arcticlula/Netscore/README.md

# Netscore
Device that keeps track of a volleyball's game score (points and sets). 

Ideally it should be mounted on the net, since it has a display on the front and back and buttons on the sides.
