arcticlula/Netscore/docs/0.8in.webp

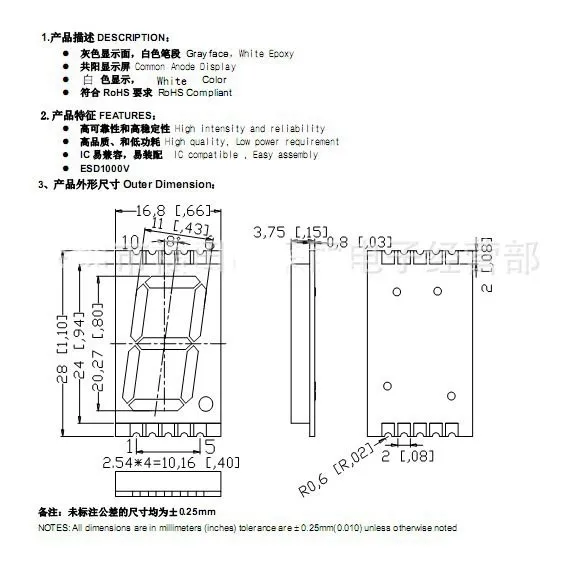
docs/0.8in.webp
