arcticlula/Netscore/docs/3P-Dial-Wheel-Switch-4-1100x1100w.jpg

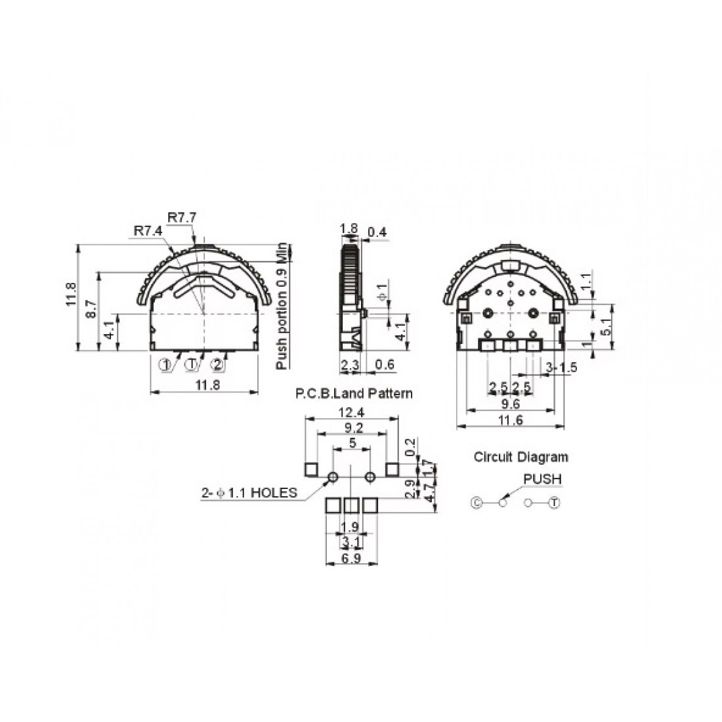
docs/3P-Dial-Wheel-Switch-4-1100x1100w.jpg
