arcticlula/Netscore/docs/esp32 s2 wroom pinout.png

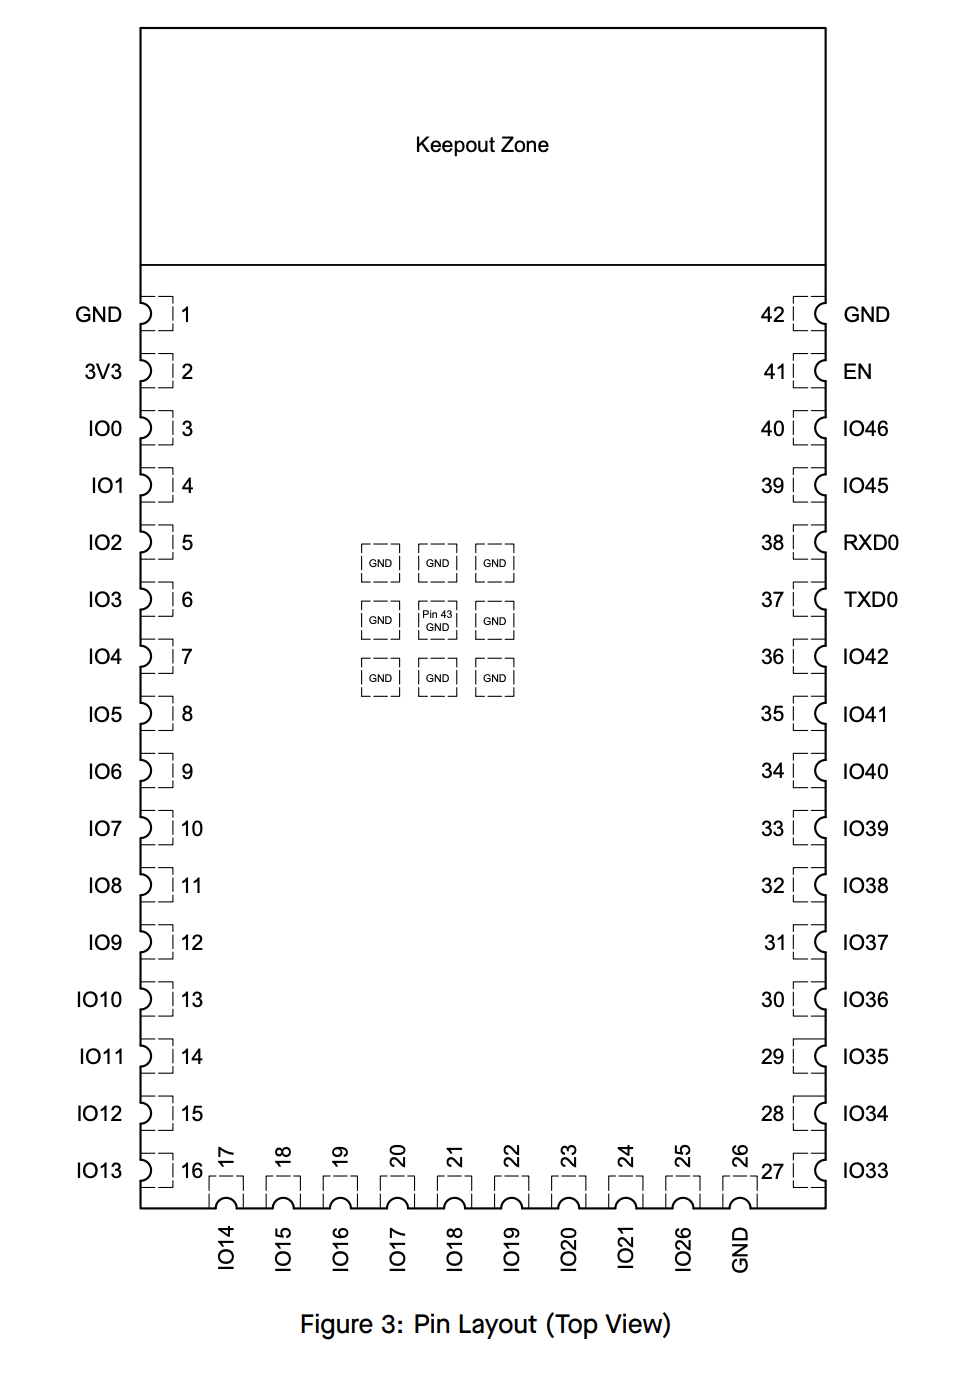
docs/esp32 s2 wroom pinout.png
