arcticlula/Netscore/docs/esp32 s3 wroom pinout.png

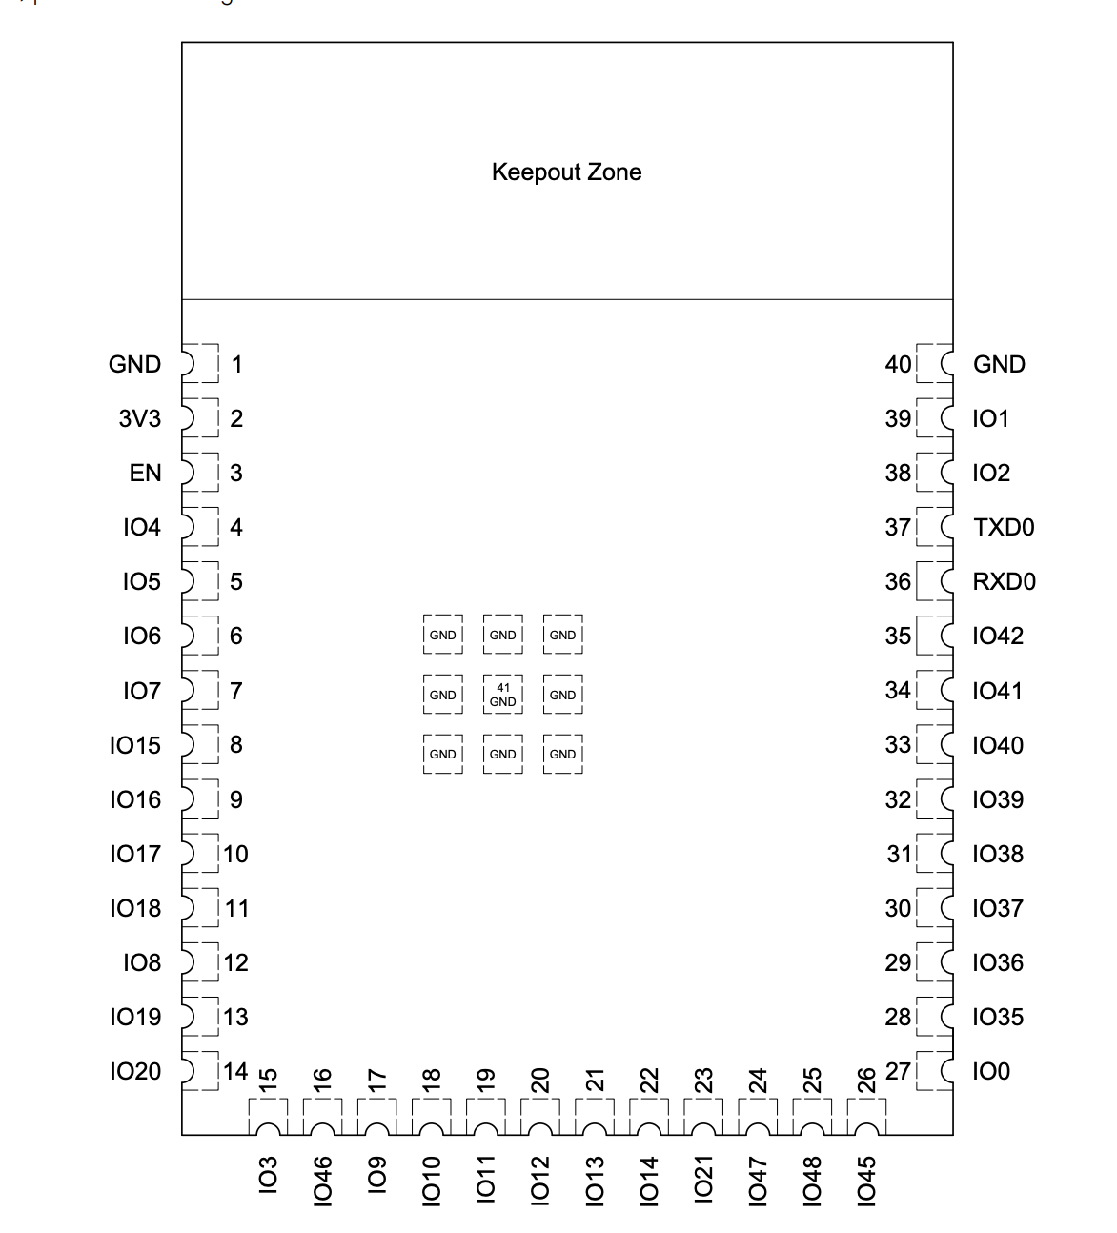
docs/esp32 s3 wroom pinout.png
