arcticlula/Netscore/docs/fish.png

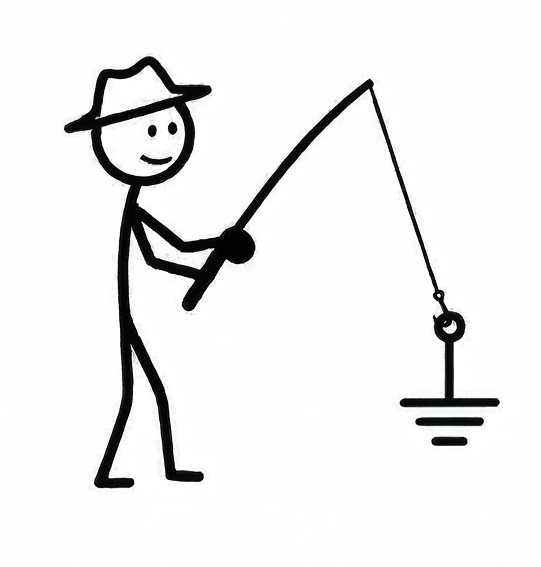
docs/fish.png
