arcticlula/Netscore/docs/rake.png

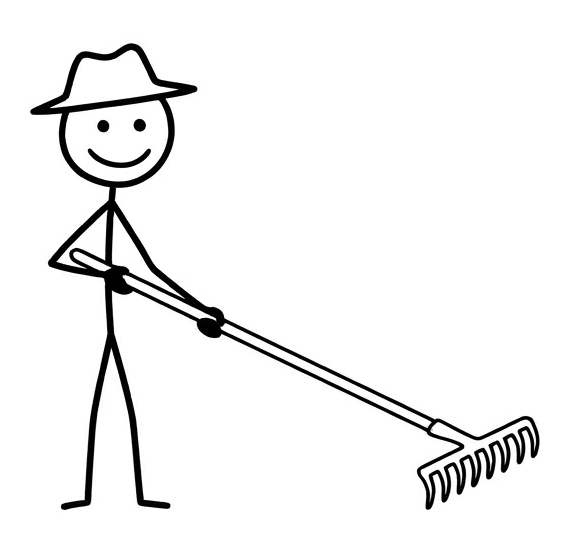
docs/rake.png
