arcticlula/Netscore/docs/S2cf5b9a6ac8e40838b927087fc219b81M.webp

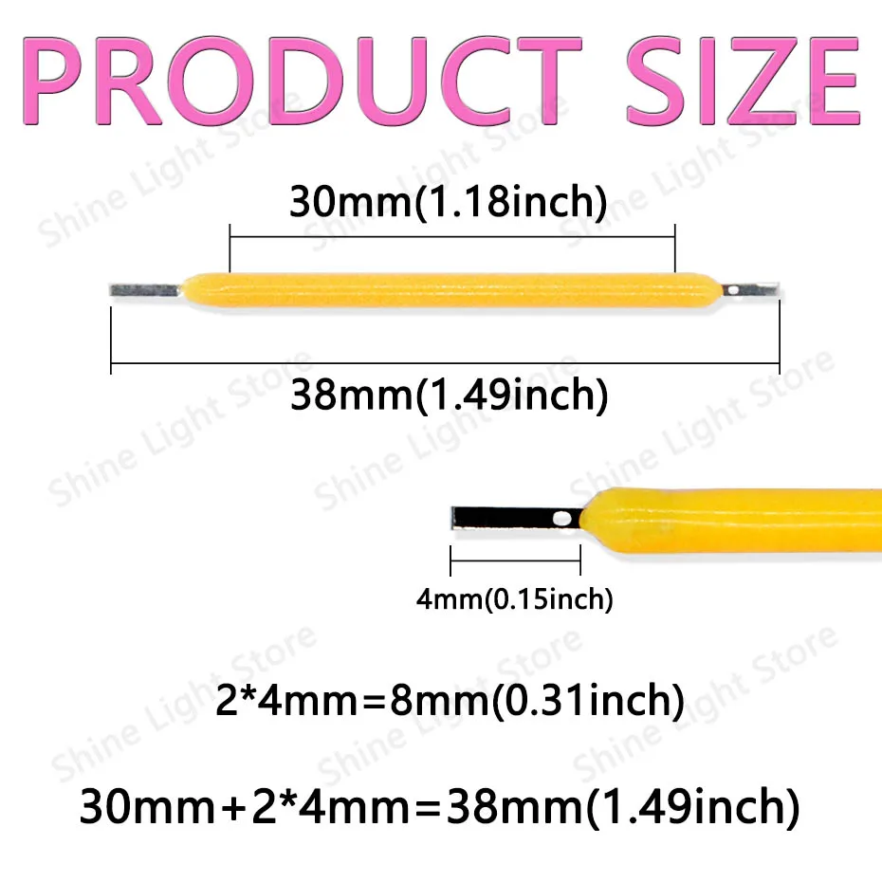
docs/S2cf5b9a6ac8e40838b927087fc219b81M.webp
