arcticlula/Netscore/docs/S14ab36efa070481e8fa8c75f21a35941z.webp

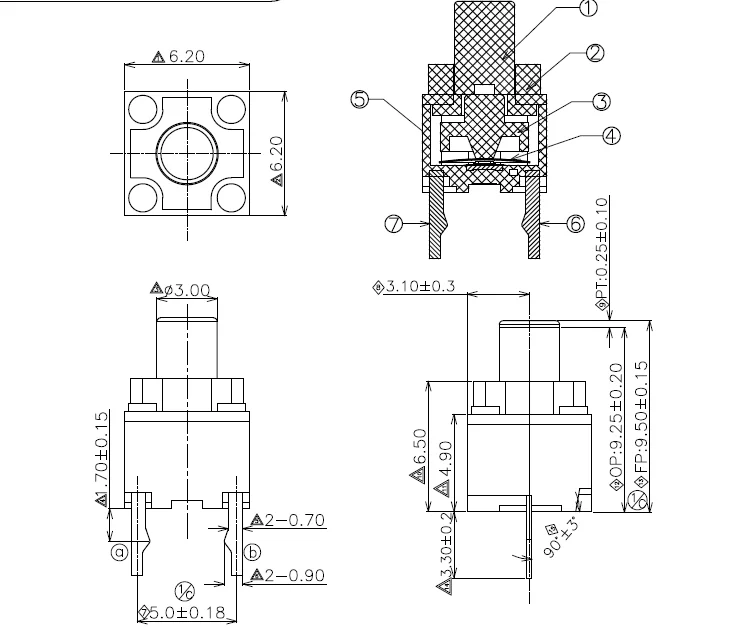
docs/S14ab36efa070481e8fa8c75f21a35941z.webp
