arcticlula/Netscore/docs/S18a682a4f3614c669764446a9c4d551fz.webp

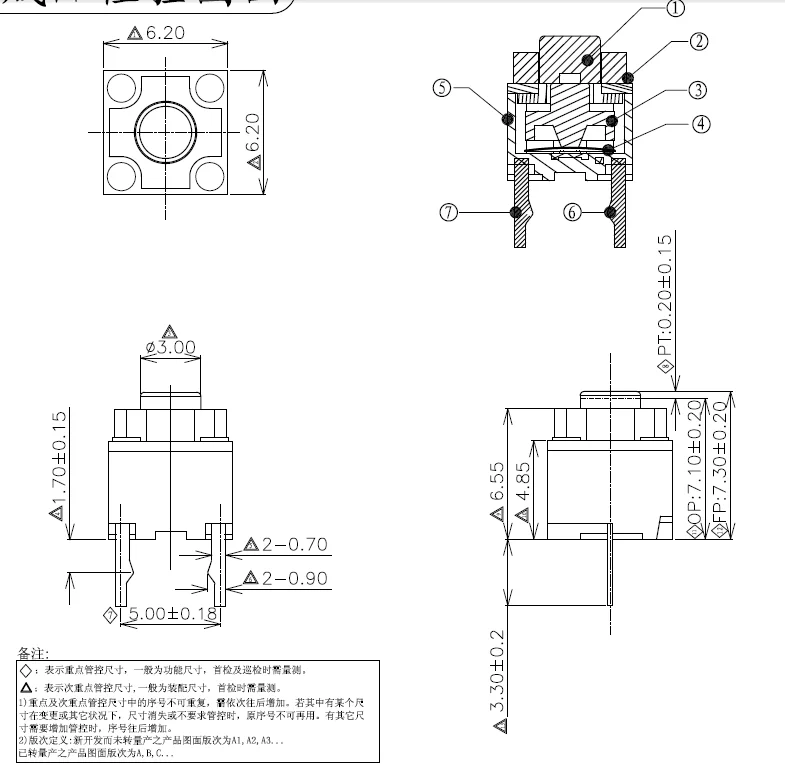
docs/S18a682a4f3614c669764446a9c4d551fz.webp
