arcticlula/Netscore/docs/S4806a1bc822145efa5b5a5cded0fcb83w.webp

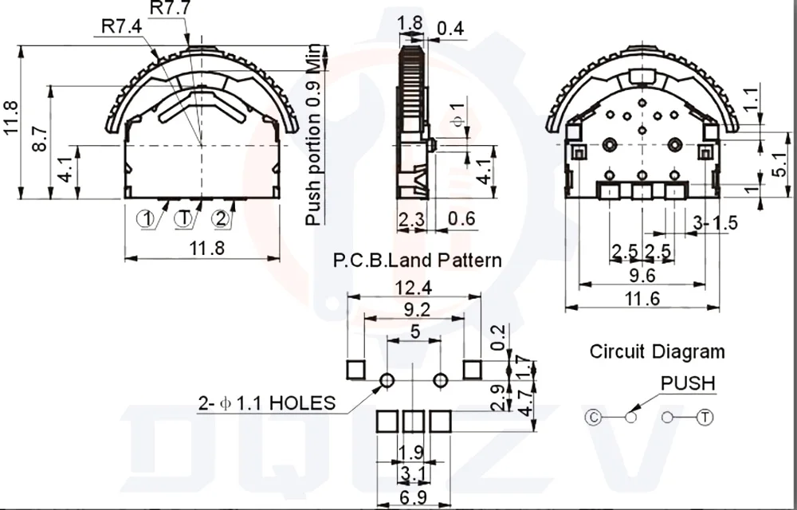
docs/S4806a1bc822145efa5b5a5cded0fcb83w.webp
