arcticlula/Netscore/docs/Sd6c0362663b042cd87066699b7182b00w.webp

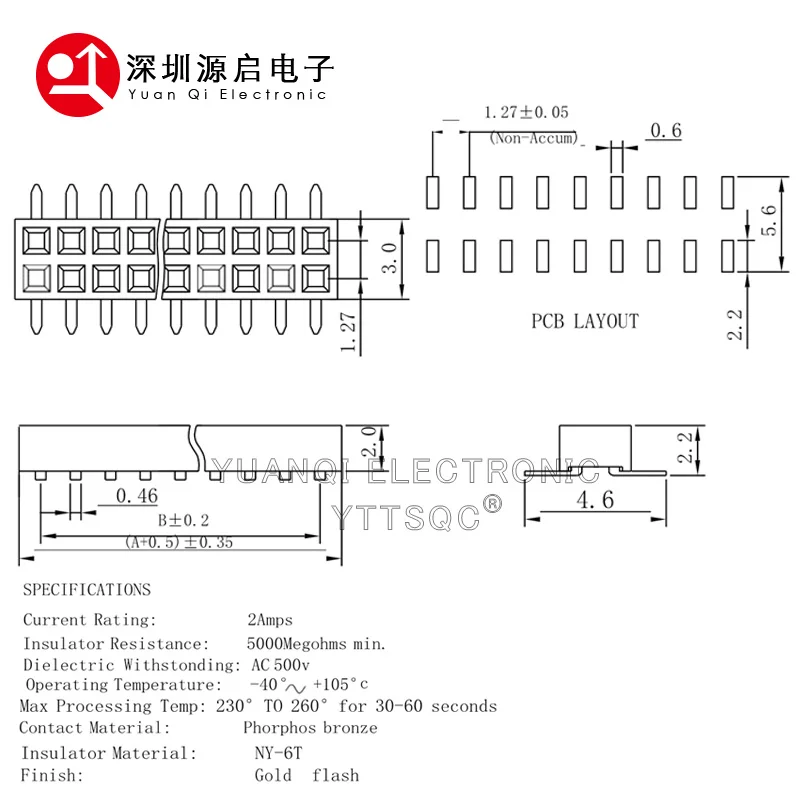
docs/Sd6c0362663b042cd87066699b7182b00w.webp
