arcticlula/Netscore/software/web/web sim 2/ab_shutter_1btn.png

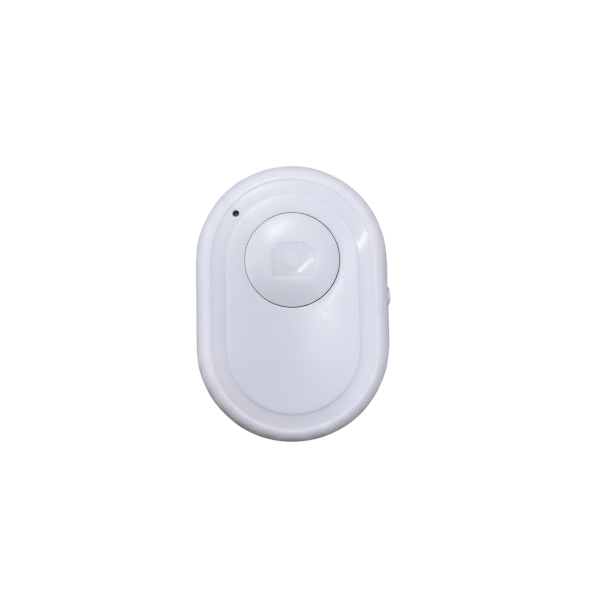
software/web/web sim 2/ab_shutter_1btn.png
