arcticlula/Netscore/software/web/web sim 2/ab_shutter_2btn.png

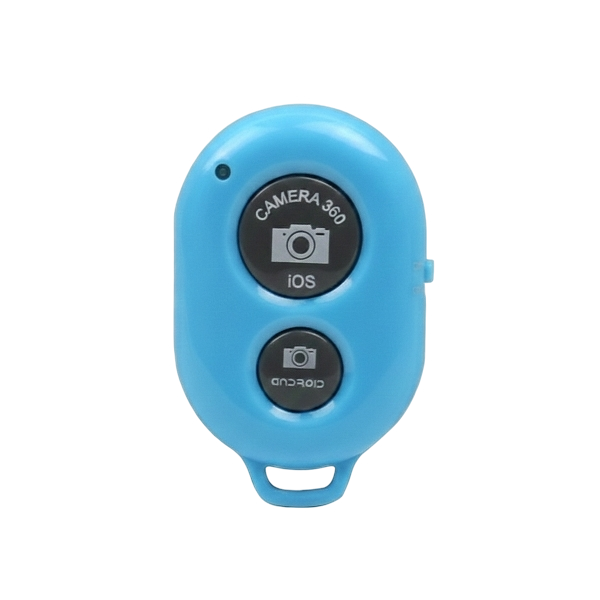
software/web/web sim 2/ab_shutter_2btn.png
