arcticlula/Netscore/hardware/struct/v2/outer/top big.3mf

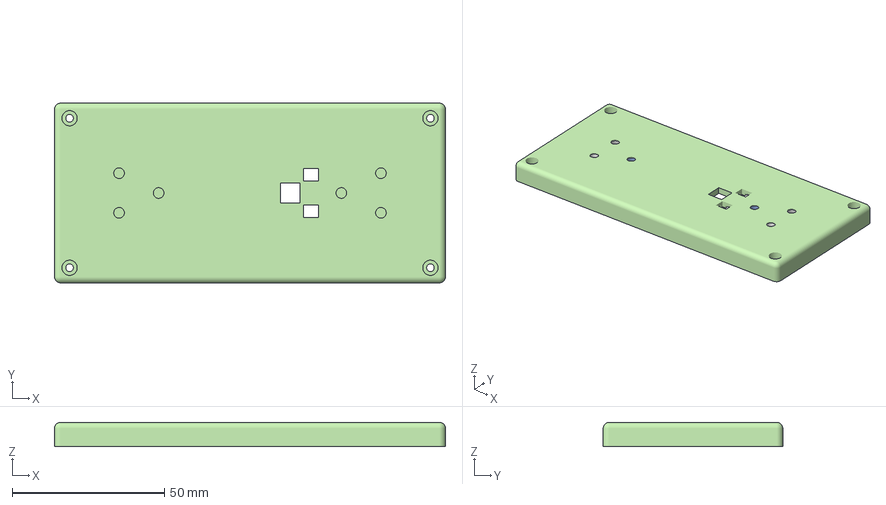
[picture p14: CAD file, 2026-06-29]
hardware/struct/v2/outer/top big.3mf
128.4 x 59.0 x 8.00 mm
Top
