arcticlula/Netscore/hardware/struct/v2/test-rig/test-body-v1.1.stl

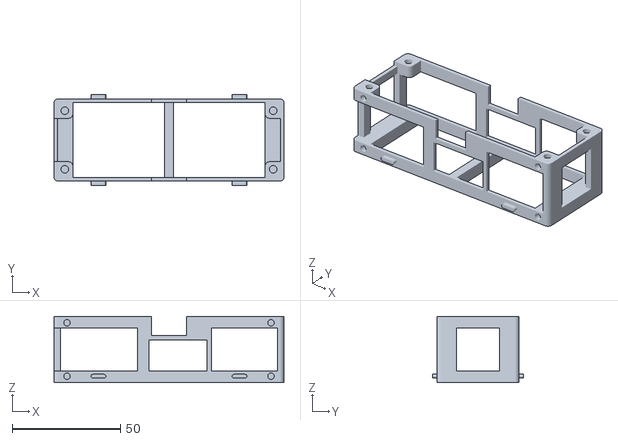
[picture p15: CAD file, 2026-04-30]
hardware/struct/v2/test-rig/test-body-v1.1.stl
106.0 x 42.0 x 30.6
