arcticlula/Netscore/hardware/struct/v2/outer/outer-bottom-big-v1.0.stl

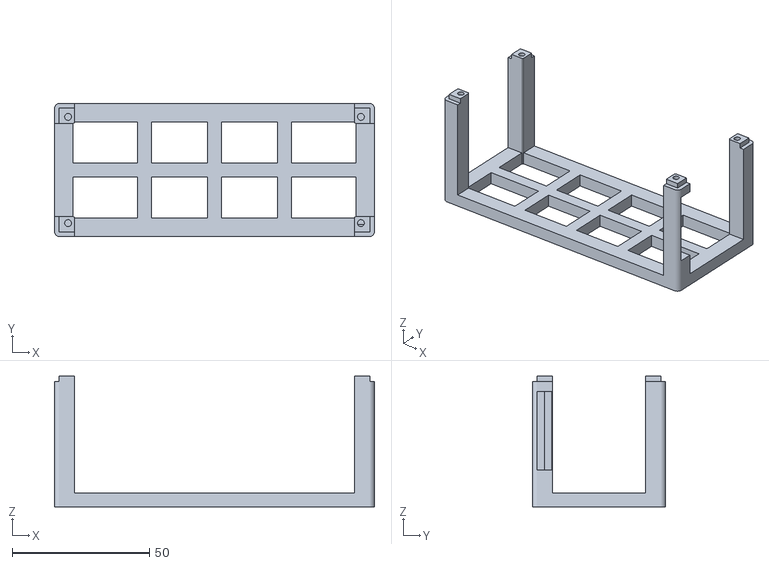
[picture p16: CAD file, 2026-06-29]
hardware/struct/v2/outer/outer-bottom-big-v1.0.stl
116.6 x 48.6 x 47.6
