arcticlula/Netscore/hardware/struct/v2/inner/inner-body-v1.7.stl

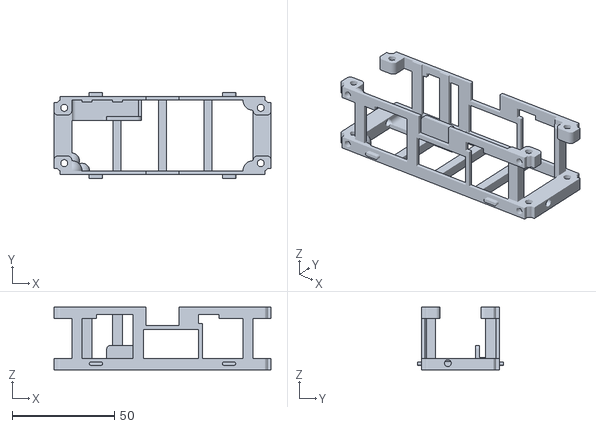
[picture p17: CAD file, 2026-05-18]
hardware/struct/v2/inner/inner-body-v1.7.stl
106.0 x 42.0 x 30.6
