arcticlula/Netscore/hardware/struct/v2/test-rig/test-front-v1.0.stl

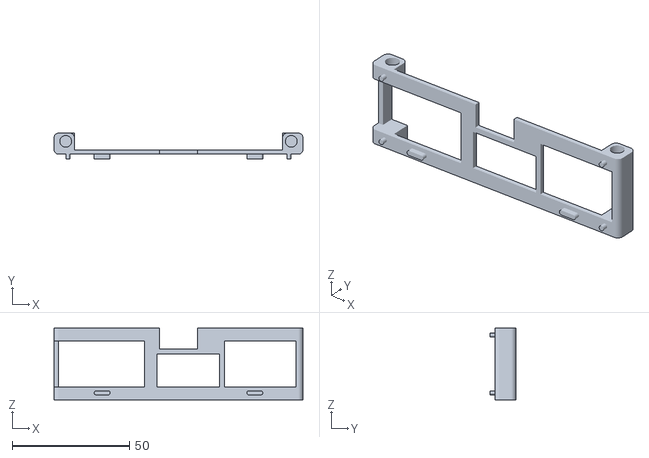
[picture p18: CAD file, 2026-04-30]
hardware/struct/v2/test-rig/test-front-v1.0.stl
106.0 x 11.0 x 30.6
