arcticlula/Netscore/hardware/struct/v2/inner/inner-speaker-holder-centered-v1.0.stl

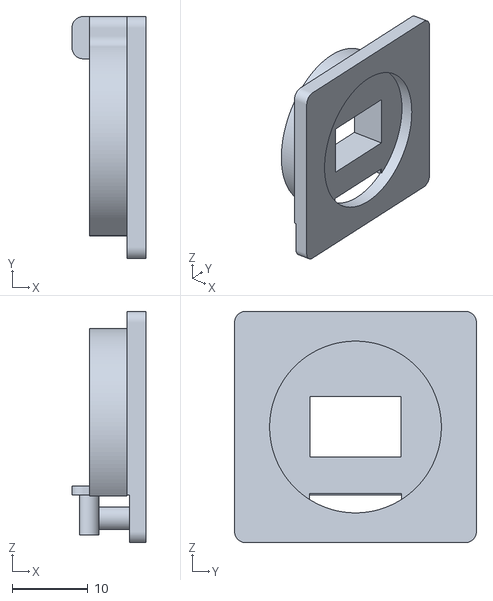
[picture p19: CAD file, 2026-05-18]
hardware/struct/v2/inner/inner-speaker-holder-centered-v1.0.stl
9.79 x 32.0 x 30.6
