arcticlula/Netscore/hardware/struct/v2/outer/outer-top-v1.1.stl

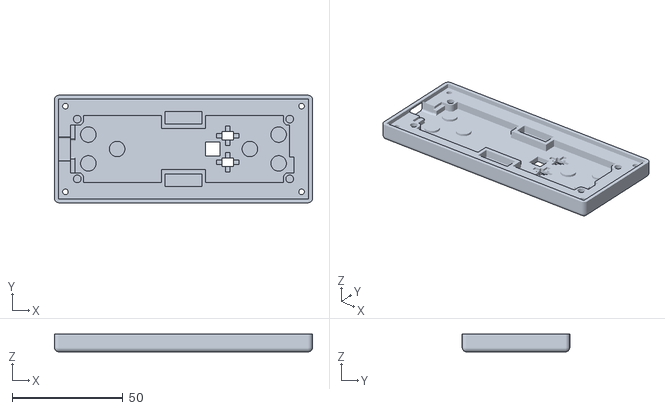
[picture p20: CAD file, 2026-05-18]
hardware/struct/v2/outer/outer-top-v1.1.stl
116.6 x 48.6 x 8.00
