arcticlula/Netscore/hardware/struct/v2/test-rig/test-top-v1.2.stl

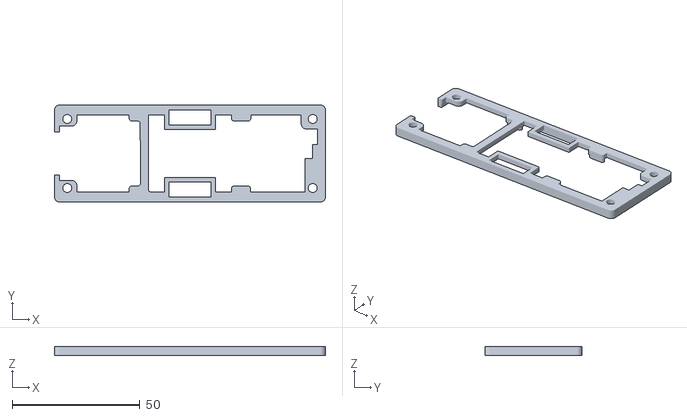
[picture p21: CAD file, 2026-04-30]
hardware/struct/v2/test-rig/test-top-v1.2.stl
106.0 x 38.0 x 3.60
