arcticlula/Netscore/hardware/struct/v2/outer/outer-bottom-v1.0.stl

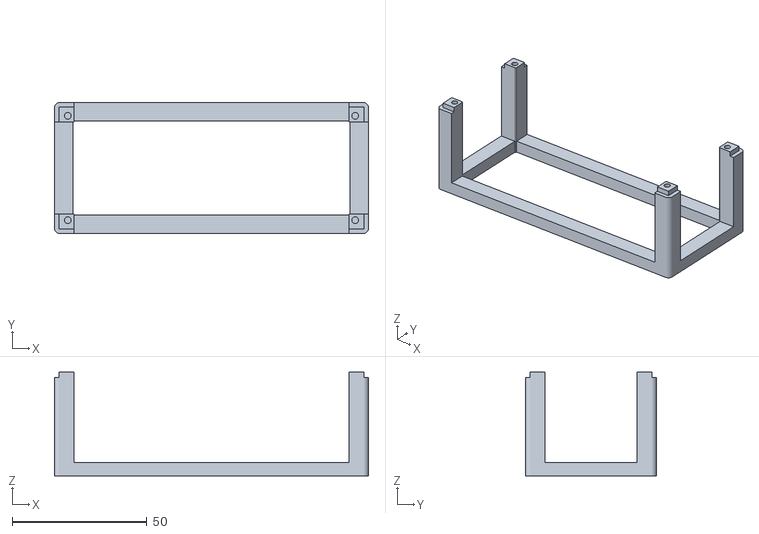
[picture p22: CAD file, 2026-04-30]
hardware/struct/v2/outer/outer-bottom-v1.0.stl
116.6 x 48.6 x 38.6
