arcticlula/Netscore/hardware/struct/v2/inner/inner-speaker-holder-v1.6.stl

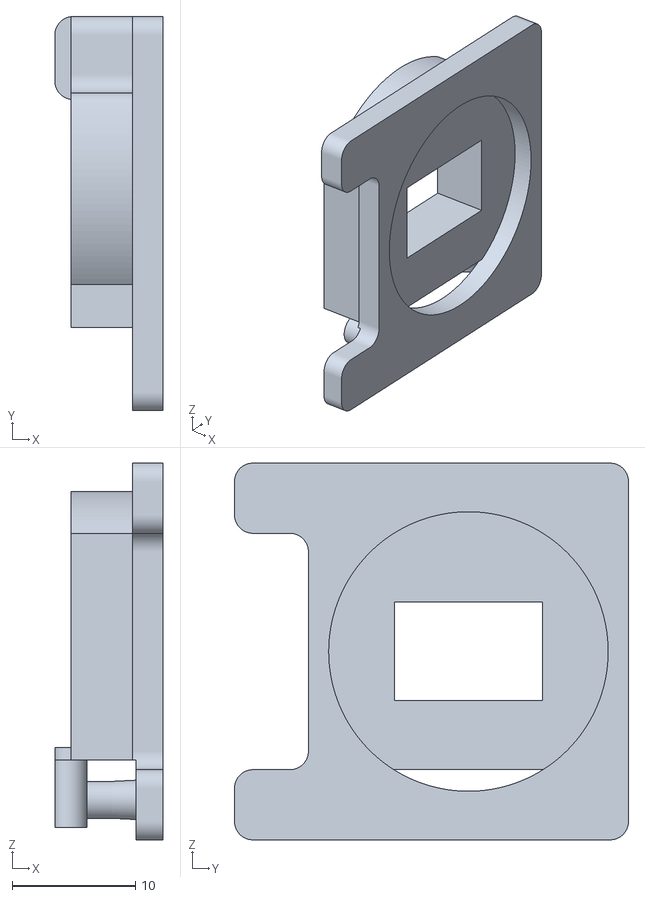
[picture p23: CAD file, 2026-05-18]
hardware/struct/v2/inner/inner-speaker-holder-v1.6.stl
8.80 x 32.0 x 30.6
