arcticlula/Netscore/hardware/struct/v2/outer/outer-addon-v1.0.stl

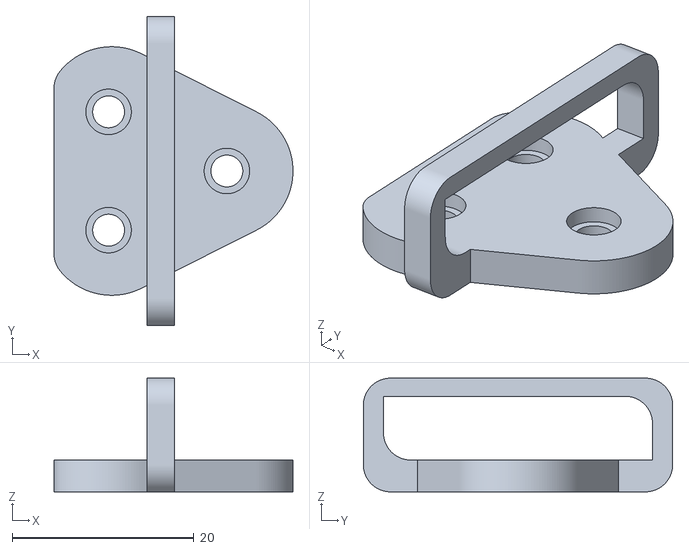
[picture p24: CAD file, 2026-04-30]
hardware/struct/v2/outer/outer-addon-v1.0.stl
26.3 x 34.0 x 12.5
