arcticlula/Netscore/hardware/struct/v2/inner/inner-body-big-v1.0.stl

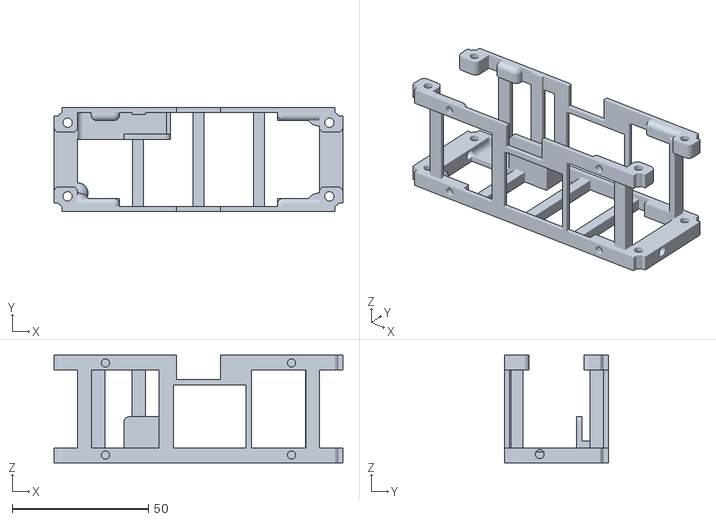
[picture p25: CAD file, 2026-05-18]
hardware/struct/v2/inner/inner-body-big-v1.0.stl
106.0 x 38.0 x 39.6
