arcticlula/Netscore/hardware/struct/v1/inner/inner-struct-v2.0.stl

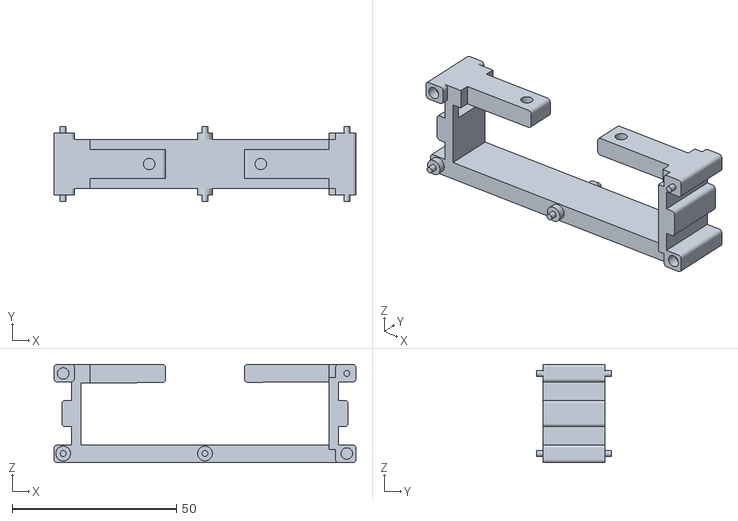
[picture p26: CAD file, 2026-03-03, an earlier design]
hardware/struct/v1/inner/inner-struct-v2.0.stl
92.0 x 22.8 x 30.0
