arcticlula/Netscore/hardware/struct/v1/outer/outer-bottom-v2.0a.stl

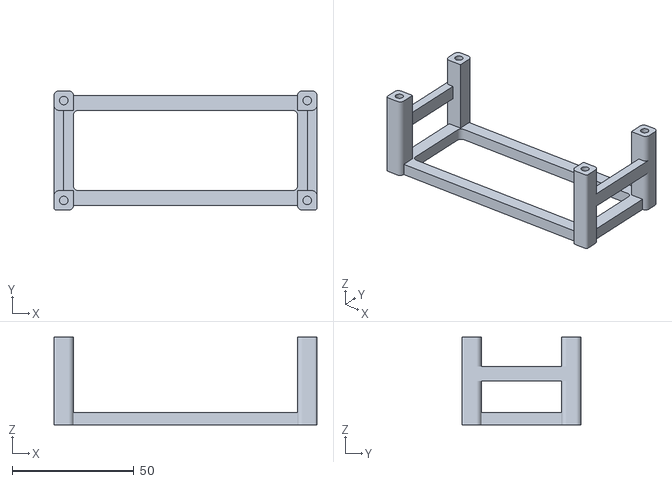
[picture p27: CAD file, 2026-03-03, an earlier design]
hardware/struct/v1/outer/outer-bottom-v2.0a.stl
108.0 x 49.0 x 36.0
