arcticlula/Netscore/hardware/struct/v1/inner/inner-struct-v2.1.stl

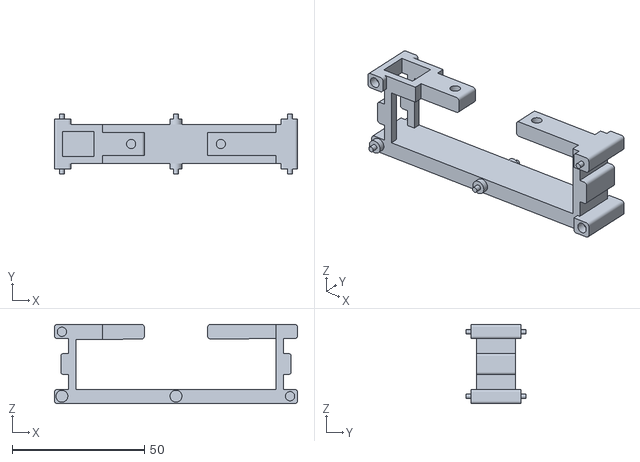
[picture p28: CAD file, 2026-03-03, an earlier design]
hardware/struct/v1/inner/inner-struct-v2.1.stl
92.0 x 22.8 x 30.0
