arcticlula/Netscore/(list of files, cad)

Other CAD files:
hardware/struct/v2/outer/gg.stl
hardware/struct/v2/outer/outer-top-big-v1.0.stl
hardware/struct/v2/inner/inner-speaker-holder-v1.5.stl
hardware/struct/v1/inner/inner-struct-union-v1.0.stl
hardware/struct/v1/inner/inner-struct-v0.1.stl
hardware/struct/v1/inner/inner-struct-v0.2.stl
hardware/struct/v1/inner/inner-struct-v0.5.stl
hardware/struct/v1/inner/inner-struct-v1.0.stl
hardware/struct/v1/outer/btn-v1.0.stl
hardware/struct/v1/outer/outer-bottom-v1.0.stl
hardware/struct/v1/outer/outer-bottom-v2.0b.stl
hardware/struct/v1/outer/outer-handle-v0.5.stl
hardware/struct/v1/outer/outer-handle-v1.0.stl
hardware/struct/v1/outer/outer-middle-v0.1.stl
hardware/struct/v1/outer/outer-top-v0.5.stl
hardware/struct/v1/outer/outer-top-v0.6.stl
hardware/struct/v1/outer/outer-top-v1.0.stl
hardware/struct/v1/outer/spacer-v0.5.stl
hardware/struct/v2/inner/inner-body-v1.0.stl
hardware/struct/v2/inner/inner-body-v1.1.stl
hardware/struct/v2/inner/inner-body-v1.5.stl
hardware/struct/v2/inner/inner-body-v1.6.stl
hardware/struct/v2/inner/inner-speaker-holder-v1.0.stl
hardware/struct/v2/inner/inner-speaker-holder-v1.1.stl
hardware/struct/v2/inner/inner-speaker-holder-v1.2.stl
hardware/struct/v2/inner/inner-speaker-holder-v1.3.stl
hardware/struct/v2/inner/inner-speaker-holder-v1.4.stl
hardware/struct/v2/outer/outer-top-v1.0.stl
hardware/struct/v2/test-rig/test-body-v1.0.stl
hardware/struct/v2/test-rig/test-top-v1.0.stl
hardware/struct/v2/test-rig/test-top-v1.1.stl
