arcticlula/Netscore/hardware/pcb/v2.1/main-board/main-board.kicad_pcb

## KiCad design hardware/pcb/v2.1/main-board/main-board.kicad_pcb (2026-03-19)

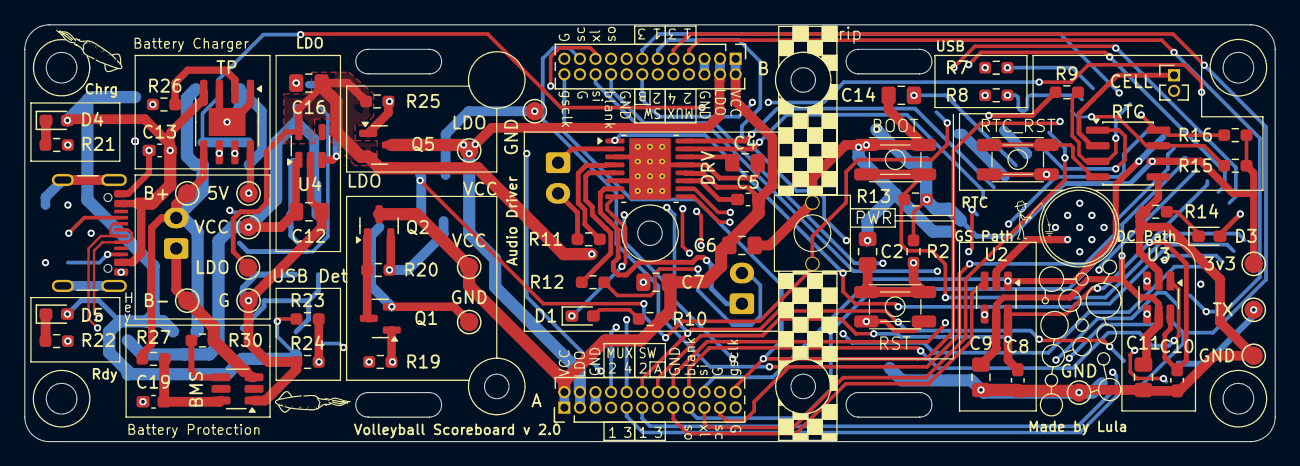
[picture p31: board hardware/pcb/v2.1/main-board/main-board.kicad_pcb from above]

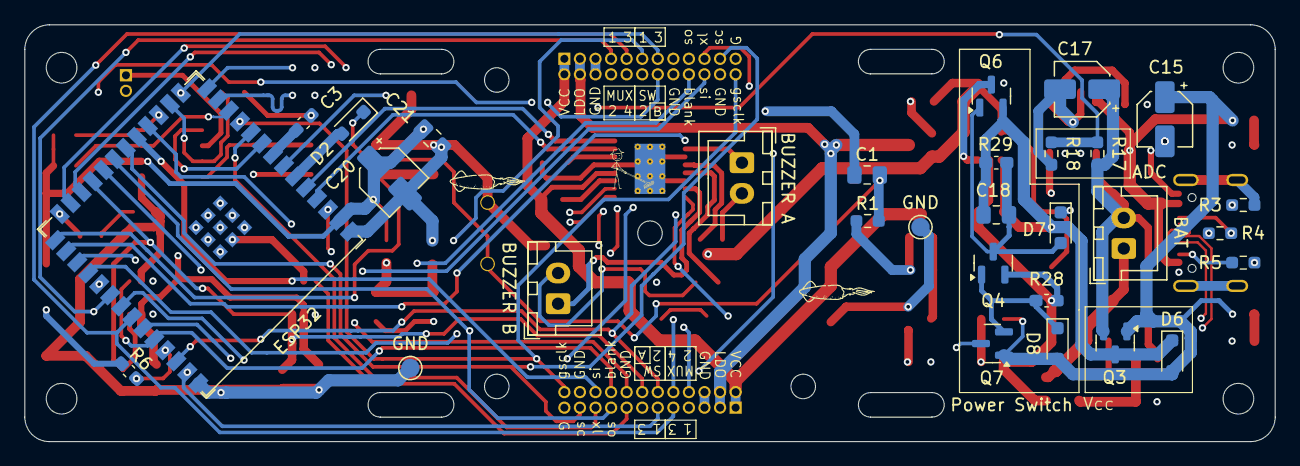
[picture p32: board hardware/pcb/v2.1/main-board/main-board.kicad_pcb from below]

Board: 4 copper layers, 102.0 x 34.0 mm, 109 parts (30 on the bottom side), 80 nets.

Parts:
3v3, 5V: TestPoint_Alt; TestPoint_Pad_D1.5mm
A: Conn_02x12_Odd_Even; PinHeader_2x12_P1.27mm_Vertical
B: Conn_02x12_Odd_Even; PinHeader_2x12_P1.27mm_Vertical
B+: TestPoint_Alt; TestPoint_Pad_D1.5mm
B-: TestPoint_Alt; TestPoint_Pad_D1.5mm
BAT: Conn_01x02_Pin; JST_XH_B2B-XH-A_1x02_P2.50mm_Vertical
BMS: FS312MH; SOT-23-6_Handsoldering
BOOT: SW_Push; Button_3x4x2.5
BUZZER A: Conn_01x02_Pin; JST_XH_B2B-XH-A_1x02_P2.50mm_Vertical
BUZZER B: Conn_01x02_Pin; JST_XH_B2B-XH-A_1x02_P2.50mm_Vertical
C1, C2: 100nF; C_0805_2012Metric_Pad1.18x1.45mm_HandSolder
C3, C8, C10: 1nF; C_0603_1608Metric_Pad1.08x0.95mm_HandSolder
C4: 2.2uF; C_0805_2012Metric_Pad1.18x1.45mm_HandSolder
C5: 10nF; C_0603_1608Metric_Pad1.08x0.95mm_HandSolder
C6: 10uF; C_0805_2012Metric_Pad1.18x1.45mm_HandSolder
C7, C9, C11, C14, C18, C21: 0.1uF; C_0805_2012Metric_Pad1.18x1.45mm_HandSolder
C12, C16: 1uF; C_0805_2012Metric_Pad1.18x1.45mm_HandSolder
C13, C19: 100nF; C_0603_1608Metric_Pad1.08x0.95mm_HandSolder
C15, C17, C20: 10uF; CP_Elec_4x5.3
CELL: Conn_01x02_Pin; PinHeader_1x02_P1.27mm_Vertical
D1, D3, D4, D5: LED; LED_0603_1608Metric_Pad1.05x0.95mm_HandSolder
D2, D6, D7, D8: BAT20J; D_SOD-323_HandSoldering
DRV: DRV8833PWP; HTSSOP-16-1EP_4.4x5mm_P0.65mm_EP3.4x5mm_Mask2.46x2.31mm_The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
ESP32: ESP32-S3-WROOM-1; ESP32-S3-WROOM-1U
G: TestPoint_Alt; TestPoint_Pad_D1.5mm
GND: TestPoint_Alt; TestPoint_Pad_D1.5mm
GND#2, GND#3, GND#4, GND#5, GND#6: TestPoint_Alt; TestPoint_Pad_D1.5mm
H1, H2, H3, H4, H5, H6, H7, H8: MountingHole; MountingHole_2mm
J1: USB_C_Receptacle_USB2.0_16P; USB_C_Receptacle_GCT_USB4105-xx-A_16P_TopMnt_Horizontal
LDO: TestPoint_Alt; TestPoint_Pad_D1.5mm
LDO#2: TestPoint_Alt; TestPoint_Pad_D1.5mm
PWR: SW_Push; Kahil Mute 6.2x6.2x7.3
Q1, Q4: AO3400A; SOT-23
Q2, Q3, Q5, Q6, Q7: AO3401A; SOT-23
R1, R2, R13: 10k; R_0603_1608Metric_Pad0.98x0.95mm_HandSolder
R3, R7, R8: 0; R_0603_1608Metric_Pad0.98x0.95mm_HandSolder
R4, R5: 5.1K; R_0603_1608Metric_Pad0.98x0.95mm_HandSolder
R6: 499; C_0603_1608Metric_Pad1.08x0.95mm_HandSolder
R9, R17, R18, R19, R20, R24, R25: 100k; R_0603_1608Metric_Pad0.98x0.95mm_HandSolder
R10, R14, R21, R22: 2.2K; R_0603_1608Metric_Pad0.98x0.95mm_HandSolder
R11, R12: 300; R_0603_1608Metric_Pad0.98x0.95mm_HandSolder
R15, R16: 4.7k; R_0603_1608Metric_Pad0.98x0.95mm_HandSolder
R23: 56k; R_0603_1608Metric_Pad0.98x0.95mm_HandSolder
R26: R; R_0603_1608Metric_Pad0.98x0.95mm_HandSolder
R27: 100; R_0603_1608Metric_Pad0.98x0.95mm_HandSolder
R28, R29: 100k; C_0603_1608Metric_Pad1.08x0.95mm_HandSolder
R30: 2K; R_0603_1608Metric_Pad0.98x0.95mm_HandSolder
RST: SW_Push; Button_3x4x2.5
RTC: DS3231MZ; SOIC-8_3.9x4.9mm_P1.27mm
RTC_RST: SW_Push; Button_3x4x2.5
TP: TP4056; SOIC-8-1EP_3.9x4.9mm_P1.27mm_EP2.29x3mm
TX: TestPoint_Alt; TestPoint_Pad_D1.5mm
U2, U3: 74LVC1G3157; SOT-23-6_Handsoldering
U4: AP2112K-3.3; SOT-23-5
VCC: TestPoint_Alt; TestPoint_Pad_D1.5mm
VCC#2: TestPoint_Alt; TestPoint_Pad_D1.5mm

Connections:
+BATT: B+.1, BAT.2, C17.1, Q3.2 (S), R17.1, R27.1, TP.5 (BAT)
-BATT: B-.1, BAT.1, BMS.3 (BAT-), R30.1
/ADC_BAT: C14.2, ESP32.7 (GPIO7/TOUCH7/ADC1_CH6), R17.2, R18.1
/BLANK: A.17, B.17, ESP32.21 (GPIO13/TOUCH13/ADC2_CH2/FSPIQ/FSPIIO7/S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)
/BUZZER_A_+: BUZZER A.1, DRV.2 (AOUT1)
/BUZZER_A_-: BUZZER A.2, R11.2
/BUZZER_B_+: BUZZER B.1, DRV.7 (BOUT1)
/BUZZER_B_-: BUZZER B.2, R12.2
/BZ_A_1: DRV.16 (AIN1), ESP32.5 (GPIO5/TOUCH5/ADC1_CH4)
/BZ_A_2: DRV.15 (AIN2), ESP32.4 (GPIO4/TOUCH4/ADC1_CH3)
/BZ_B_1: DRV.9 (BIN1), ESP32.24 (GPIO47/SPICLK_P/SUBSPICLK_P_DIFF)
/BZ_B_2: DRV.10 (BIN2), ESP32.25 (GPIO48/SPICLK_N/SUBSPICLK_N_DIFF)
/DCSIN: A.18, ESP32.36 (U0RXD/GPIO44/CLK_OUT2), U3.1
/DCSIN_B: B.18, U3.4
/DCSOUT_A: A.16, U3.3
/DRV_~SLEEP: DRV.1 (~SLEEP), ESP32.28 (SPIIO6/GPIO35/FSPID/SUBSPID)
/EN: C2.1, ESP32.3 (EN), R2.2, RST.1
/GSCLK: A.24, B.24, ESP32.11 (GPIO18/U1RXD/ADC2_CH7/CLK_OUT3)
/GSLAT: A.19, B.19, ESP32.10 (GPIO17/U1TXD/ADC2_CH6)
/GSSIN: A.20, ESP32.19 (GPIO11/TOUCH11/ADC2_CH0/FSPID/FSPIIO5/S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), U2.1
/GSSIN_B: B.20, U2.4
/GSSOUT_A: A.15, U2.3
/LDO_CTRL_EN: ESP32.29 (SPIIO7/GPIO36/FSPICLK/SUBSPICLK), Q5.1 (G), R25.2
/LDO_EN: Q6.3 (D), U4.3 (EN)
/LDO_LATCH: ESP32.18 (GPIO10/TOUCH10/ADC1_CH9/FSPICS0/FSPIIO4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), Q7.3 (D)
/MUX_1: A.7, B.7, ESP32.32 (MTCK/GPIO39/CLK_OUT3/SUBSPICS1)
/MUX_2: A.8, B.8, ESP32.33 (MTDO/GPIO40/CLK_OUT2)
/MUX_3: A.9, B.9, ESP32.34 (MTDI/GPIO41/CLK_OUT1)
/MUX_4: A.10, B.10, ESP32.35 (MTMS/GPIO42)
/RTC_BAT_+: CELL.1, RTC.2 (VCC)
/RTC_CLK: ESP32.9 (GPIO16/U0CTS/ADC2_CH5/XTAL_32K_N), RTC.1 (32KHZ)
/RTC_SCL: ESP32.17 (GPIO9/TOUCH9/ADC1_CH8/FSPIHD/SUBSPIHD), R16.1, RTC.8 (SCL)
/RTC_SDA: ESP32.12 (GPIO8/TOUCH8/ADC1_CH7/SUBSPICS1), R15.1, RTC.7 (SDA)
/RTC_~INT: ESP32.16 (GPIO46), R9.1, RTC.3 (~INT/SQW)
/SCLK: A.21, B.21, ESP32.20 (GPIO12/TOUCH12/ADC2_CH1/FSPICLK/FSPIIO6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)
/SLOT_A_DET: A.14, C8.1, C10.1, ESP32.23 (GPIO21), U2.6, U3.6
/SLOT_B_DET: B.14, ESP32.31 (GPIO38/FSPIWP/SUBSPIWP)
/SW_1: A.11, B.11, ESP32.39 (GPIO1/TOUCH1/ADC1_CH0)
/SW_2: A.12, B.12, ESP32.38 (GPIO2/TOUCH2/ADC1_CH1)
/SW_3: A.13, B.13, ESP32.15 (GPIO3/TOUCH3/ADC1_CH2)
/SW_PWR: C1.1, D2.1 (K), D7.1 (K), PWR.1, R1.2
/U0TXD: R6.2, TX.1
/USB_D+: J1.A6 (D+), J1.B6 (D+), R7.2
/USB_D-: J1.A7 (D-), J1.B7 (D-), R8.2
/VBUS_DET: ESP32.22 (GPIO14/TOUCH14/ADC2_CH3/FSPIWP/FSPIDQS/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), R23.2, R24.1
/VCC_CTRL_EN: ESP32.30 (SPIDQS/GPIO37/FSPIQ/SUBSPIQ), Q1.1 (G), R19.1
GND: A.5, A.6, A.22, A.23, B.5, B.6, B.22, B.23, BMS.1 (GND), BOOT.1, C1.2, C2.2, C3.1, C4.1, C6.1, C7.1, C8.2, C9.1, C10.2, C11.1, C12.2, C13.2, C14.1, C15.2, C16.2, C17.2, C19.2, C20.2, C21.1, CELL.2, DRV.3 (AISEN), DRV.6 (BISEN), DRV.13 (GND), DRV.17 (GND), ESP32.1 (GND), ESP32.40 (GND), ESP32.41 (GND), G.1, GND.1, GND#2.1, GND#3.1, GND#4.1, GND#5.1, GND#6.1, J1.A1 (GND), J1.A12 (GND), J1.B1 (GND), J1.B12 (GND), PWR.2, Q1.2 (S), Q4.2 (S), R3.1, R4.1, R5.1, R9.2, R14.2, R18.2, R19.2, R24.2, R26.2, R28.2, RST.2, RTC.5 (GND), RTC_RST.1, TP.1 (TEMP), TP.3 (GND), TP.9 (PP), U2.2 (GND), U3.2 (GND), U4.2 (GND)
LDO: 3v3.1, C16.1, C20.1, C21.2, ESP32.2 (3V3), LDO.1, Q5.2 (S), R2.1, R13.1, R15.2, R16.2, R25.1, RTC.6 (VBAT), U4.5 (VOUT)
LDO_CTRL: A.3, A.4, B.3, B.4, C9.2, C11.2, LDO#2.1, Q5.3 (D), U2.5 (VCC), U3.5 (VCC)
unnamed: BMS.4 (CS), R30.2
unnamed: BMS.6 (VCC), C19.1, R27.2
unnamed: D1.2 (A), R10.2
unnamed: D1.1 (K), DRV.8 (~FAULT)
unnamed: D2.2 (A), ESP32.6 (GPIO6/TOUCH6/ADC1_CH5)
unnamed: D3.2 (A), ESP32.26 (GPIO45)
unnamed: D3.1 (K), R14.1
unnamed: D4.1 (K), R21.1
unnamed: D5.1 (K), R22.1
unnamed: C18.2, D7.2 (A), Q4.3 (D), Q6.1 (G), R29.2
unnamed: D8.1 (K), Q4.1 (G), Q7.2 (S), R28.1
unnamed: DRV.4 (AOUT2), R11.1
unnamed: DRV.5 (BOUT2), R12.1
unnamed: C5.1, DRV.11 (VCP)
unnamed: C4.2, DRV.14 (VINT)
unnamed: J1.A5 (CC1), R4.2
unnamed: J1.B5 (CC2), R5.2
unnamed: J1.S1 (SHIELD), R3.2
unnamed: Q1.3 (D), Q2.1 (G), R20.2
unnamed: RTC.4 (~RST), RTC_RST.2
unnamed: R26.1, TP.2 (PROG)
unnamed: R21.2, TP.7 (~CHRG)
unnamed: R22.2, TP.6 (~STDBY)
unnamed: BOOT.2, ESP32.27 (GPIO0/BOOT), R13.2
unnamed: C3.2, ESP32.8 (GPIO15/U0RTS/ADC2_CH4/XTAL_32K_P)
unnamed: ESP32.13 (GPIO19/U1RTS/ADC2_CH8/CLK_OUT2/USB_D-), R8.1
unnamed: ESP32.14 (GPIO20/U1CTS/ADC2_CH9/CLK_OUT1/USB_D+), R7.1
unnamed: ESP32.37 (U0TXD/GPIO43/CLK_OUT1), R6.1
VBUS: 5V.1, C13.1, C15.1, D4.2 (A), D5.2 (A), D6.2 (A), D8.2 (A), J1.A4 (VBUS), J1.A9 (VBUS), J1.B4 (VBUS), J1.B9 (VBUS), Q3.1 (G), Q7.1 (G), R23.1, TP.4 (VCC), TP.8 (CE)
VCC: C12.1, C18.1, D6.1 (K), Q2.2 (S), Q3.3 (D), Q6.2 (S), R1.1, R20.1, R29.1, U4.1 (VIN), VCC#2.1
VCC_CTRL: A.1, A.2, B.1, B.2, C5.2, C6.2, C7.2, DRV.12 (VM), Q2.3 (D), R10.1, VCC.1
