arcticlula/Netscore/hardware/pcb/v2.1/display-board-big/display-board.kicad_pcb

## KiCad design hardware/pcb/v2.1/display-board-big/display-board.kicad_pcb (2026-04-30)

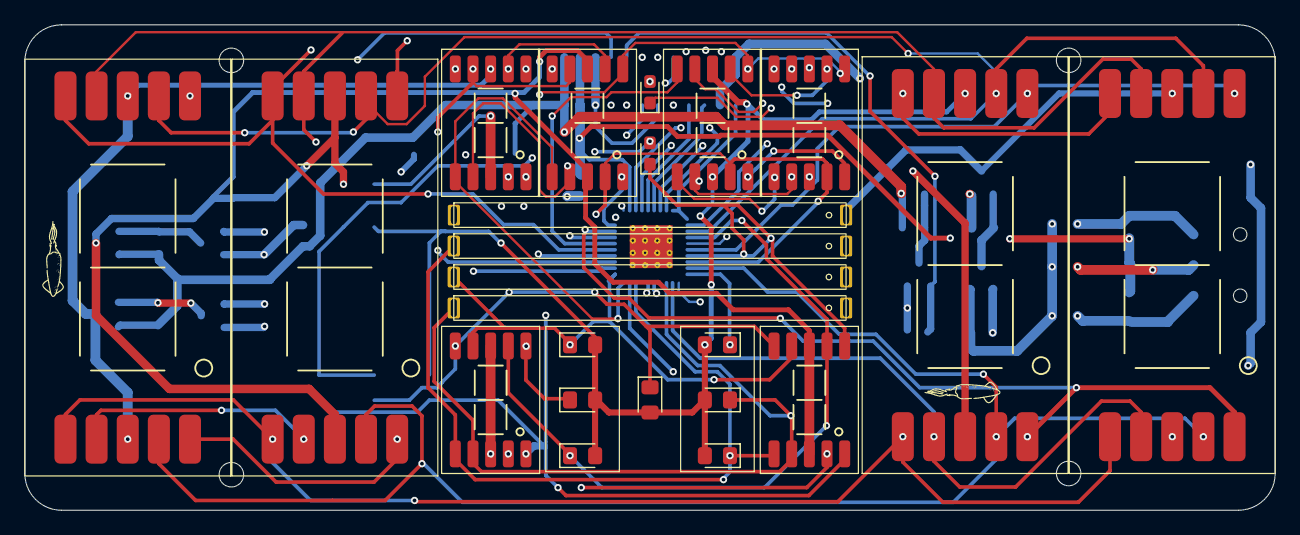
[picture p33: board hardware/pcb/v2.1/display-board-big/display-board.kicad_pcb from above]

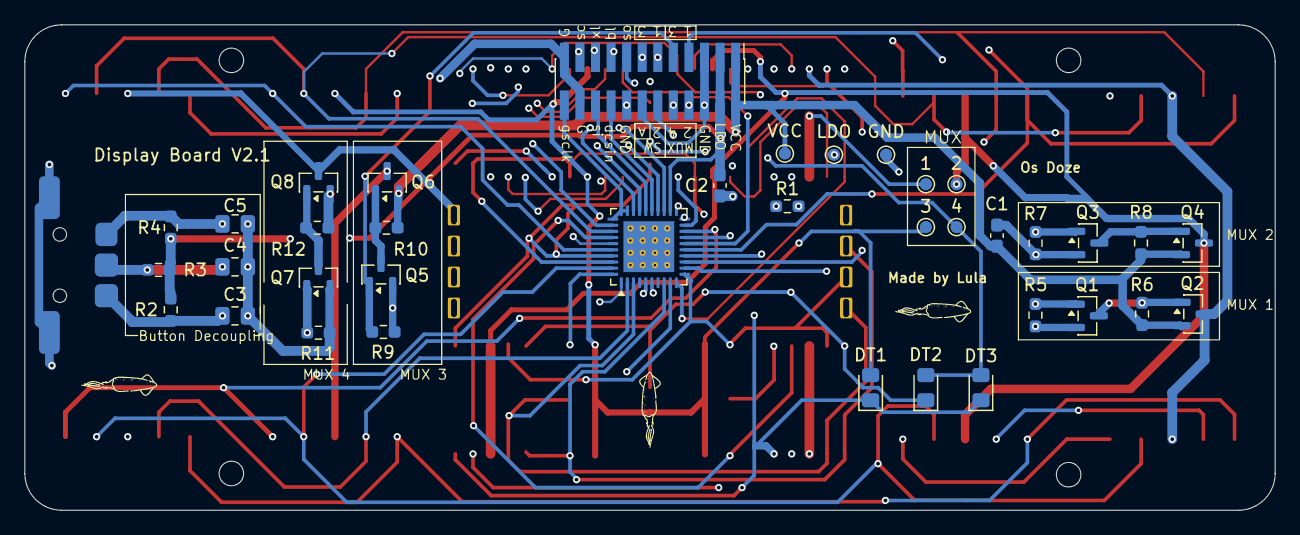
[picture p34: board hardware/pcb/v2.1/display-board-big/display-board.kicad_pcb from below]

Board: 4 copper layers, 102.0 x 39.6 mm, 65 parts (38 on the bottom side), 51 nets.

Parts:
1, 2, 3, 4: TestPoint; TestPoint_Pad_D1.0mm
A1: Conn_02x12_Odd_Even; PinHeader_2x12_P1.27mm_Vertical_SMD
C1: 10uF; C_0603_1608Metric_Pad1.08x0.95mm_HandSolder
C2: 0.1uF; C_0603_1608Metric_Pad1.08x0.95mm_HandSolder
C3, C4, C5: 2.2uF; C_0805_2012Metric_Pad1.18x1.45mm_HandSolder
D1, D6, D13, D14: BAR LED; LED Bar
D3, D4, D5, D7, D8, D9, D10: LED; LED_0805_2012Metric_Pad1.15x1.40mm_HandSolder
D11, D12: LED; LED_0603_1608Metric_Pad1.05x0.95mm_HandSolder
DT1, DT2, DT3: LED; LED_0805_2012Metric_Pad1.15x1.40mm_HandSolder
GND: TestPoint; TestPoint_Pad_D1.0mm
H1, H2, H3, H4: MountingHole; MountingHole_2mm
LDO: TestPoint; TestPoint_Pad_D1.0mm
Q1, Q3, Q5, Q7: AO3400A; SOT-23
Q2, Q4, Q6, Q8: AO3401A; SOT-23
R1: 651; R_0603_1608Metric_Pad0.98x0.95mm_HandSolder
R2, R3, R4: 100k; R_0603_1608Metric_Pad0.98x0.95mm_HandSolder
R5, R6, R7, R8, R9, R10, R11, R12: 10K; R_0603_1608Metric_Pad0.98x0.95mm_HandSolder
SW1: Thumbwheel
U1: TLC5951RHA; Texas_RHA0040B_VQFN-40-1EP_6x6mm_P0.5mm_EP4.15x4.15mm_Therm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
U2, U4, U9, U11: SMD 0.8in; 7Seg SMD 0.8in Single
U3, U5, U6, U7, U8, U10: GS-S2011AB; GS-2011AB
VCC: TestPoint; TestPoint_Pad_D1.0mm

Connections:
/7SEG_MUX_1: 1.1, Q2.3 (D), U2.3 (CA), U2.8 (CA), U3.3 (CA), U3.8 (CA), U6.3 (CA), U6.8 (CA)
/7SEG_MUX_2: 2.1, Q4.3 (D), U4.3 (CA), U4.8 (CA), U5.3 (CA), U5.8 (CA), U7.3 (CA), U7.8 (CA)
/7SEG_MUX_3: 3.1, D3.2 (A), D4.2 (A), D5.2 (A), D7.2 (A), D8.2 (A), D9.2 (A), D10.2 (A), DT1.2 (A), Q6.3 (D), U8.3 (CA), U8.8 (CA), U9.3 (CA), U9.8 (CA)
/7SEG_MUX_4: 4.1, D1.2 (A), D6.2 (A), D11.2 (A), D12.2 (A), D13.2 (A), D14.2 (A), DT2.2 (A), DT3.2 (A), Q8.3 (D), U10.3 (CA), U10.8 (CA), U11.3 (CA), U11.8 (CA)
/BLANK: A1.17, U1.23 (XBLNK)
/DCSIN: A1.18, U1.25 (DCSIN)
/DCSOUT: A1.16, U1.6 (DCSOUT)
/GSCLK: A1.24, U1.29 (GSCKG), U1.30 (GSCKR), U1.31 (GSCKB)
/GSLAT: A1.19, U1.28 (GSLAT)
/GSSIN: A1.20, U1.26 (GSSIN)
/GSSOUT: A1.15, U1.5 (GSSOUT)
/LDO_CTRL: A1.3, A1.4, C2.1, LDO.1, R2.1, R3.1, R4.1, U1.22 (VCC)
/MUX_1: A1.7, Q1.1 (G), R5.1
/MUX_2: A1.8, Q3.1 (G), R7.1
/MUX_3: A1.9, Q5.1 (G), R9.1
/MUX_4: A1.10, Q7.1 (G), R11.1
/OUTB0: D5.1 (K), D11.1 (K), U1.34 (OUTB0), U6.7 (A), U7.7 (A)
/OUTB1: D4.1 (K), D12.1 (K), U1.37 (OUTB1), U6.6 (B), U7.6 (B)
/OUTB2: D1.1 (K), D8.1 (K), U1.40 (OUTB2), U6.4 (C), U7.4 (C)
/OUTB3: D6.1 (K), D9.1 (K), U1.3 (OUTB3), U6.2 (D), U7.2 (D)
/OUTB4: D10.1 (K), D13.1 (K), U1.8 (OUTB4), U6.1 (E), U7.1 (E)
/OUTB5: D3.1 (K), D14.1 (K), U1.11 (OUTB5), U6.9 (F), U7.9 (F)
/OUTB6: D7.1 (K), DT2.1 (K), U1.14 (OUTB6), U6.10 (G), U7.10 (G)
/OUTB7: DT1.1 (K), DT3.1 (K), U1.17 (OUTB7), U6.5 (DP), U7.5 (DP)
/OUTG0: U1.32 (OUTG0), U3.7 (A), U5.7 (A), U8.7 (A), U10.7 (A)
/OUTG1: U1.35 (OUTG1), U3.6 (B), U5.6 (B), U8.6 (B), U10.6 (B)
/OUTG2: U1.38 (OUTG2), U3.4 (C), U5.4 (C), U8.4 (C), U10.4 (C)
/OUTG3: U1.1 (OUTG3), U3.2 (D), U5.2 (D), U8.2 (D), U10.2 (D)
/OUTG4: U1.10 (OUTG4), U3.1 (E), U5.1 (E), U8.1 (E), U10.1 (E)
/OUTG5: U1.13 (OUTG5), U3.9 (F), U5.9 (F), U8.9 (F), U10.9 (F)
/OUTG6: U1.16 (OUTG6), U3.10 (G), U5.10 (G), U8.10 (G), U10.10 (G)
/OUTG7: U1.19 (OUTG7), U3.5 (DP), U5.5 (DP), U8.5 (DP), U10.5 (DP)
/OUTR0: U1.33 (OUTR0), U2.7 (A), U4.7 (A), U9.7 (A), U11.7 (A)
/OUTR1: U1.36 (OUTR1), U2.6 (B), U4.6 (B), U9.6 (B), U11.6 (B)
/OUTR2: U1.39 (OUTR2), U2.4 (C), U4.4 (C), U9.4 (C), U11.4 (C)
/OUTR3: U1.2 (OUTR3), U2.2 (D), U4.2 (D), U9.2 (D), U11.2 (D)
/OUTR4: U1.9 (OUTR4), U2.1 (E), U4.1 (E), U9.1 (E), U11.1 (E)
/OUTR5: U1.12 (OUTR5), U2.9 (F), U4.9 (F), U9.9 (F), U11.9 (F)
/OUTR6: U1.15 (OUTR6), U2.10 (G), U4.10 (G), U9.10 (G), U11.10 (G)
/OUTR7: U1.18 (OUTR7), U2.5 (DP), U4.5 (DP), U9.5 (DP), U11.5 (DP)
/SCLK: A1.21, U1.24 (DCSCK), U1.27 (GSSCK)
/SW_1: A1.11, C3.1, R2.2, SW1.1
/SW_2: A1.12, C4.1, R3.2, SW1.T
/SW_3: A1.13, C5.1, R4.2, SW1.2
/VCC_CTRL: A1.1, A1.2, C1.1, Q2.2 (S), Q4.2 (S), Q6.2 (S), Q8.2 (S), R6.1, R8.1, R10.1, R12.1, VCC.1
GND: A1.5, A1.6, A1.14, A1.22, A1.23, C1.2, C2.2, C3.2, C4.2, C5.2, GND.1, Q1.2 (S), Q3.2 (S), Q5.2 (S), Q7.2 (S), R1.2, R5.2, R7.2, R9.2, R11.2, SW1.C, U1.20 (GND), U1.41 (GND)
unnamed: Q1.3 (D), Q2.1 (G), R6.2
unnamed: Q3.3 (D), Q4.1 (G), R8.2
unnamed: Q5.3 (D), Q6.1 (G), R10.2
unnamed: Q7.3 (D), Q8.1 (G), R12.2
unnamed: R1.1, U1.21 (IREF)
