arcticlula/Netscore/hardware/pcb/v1.0/display-board/display-board.kicad_pcb

## KiCad design hardware/pcb/v1.0/display-board/display-board.kicad_pcb (2025-01-12, an earlier design)

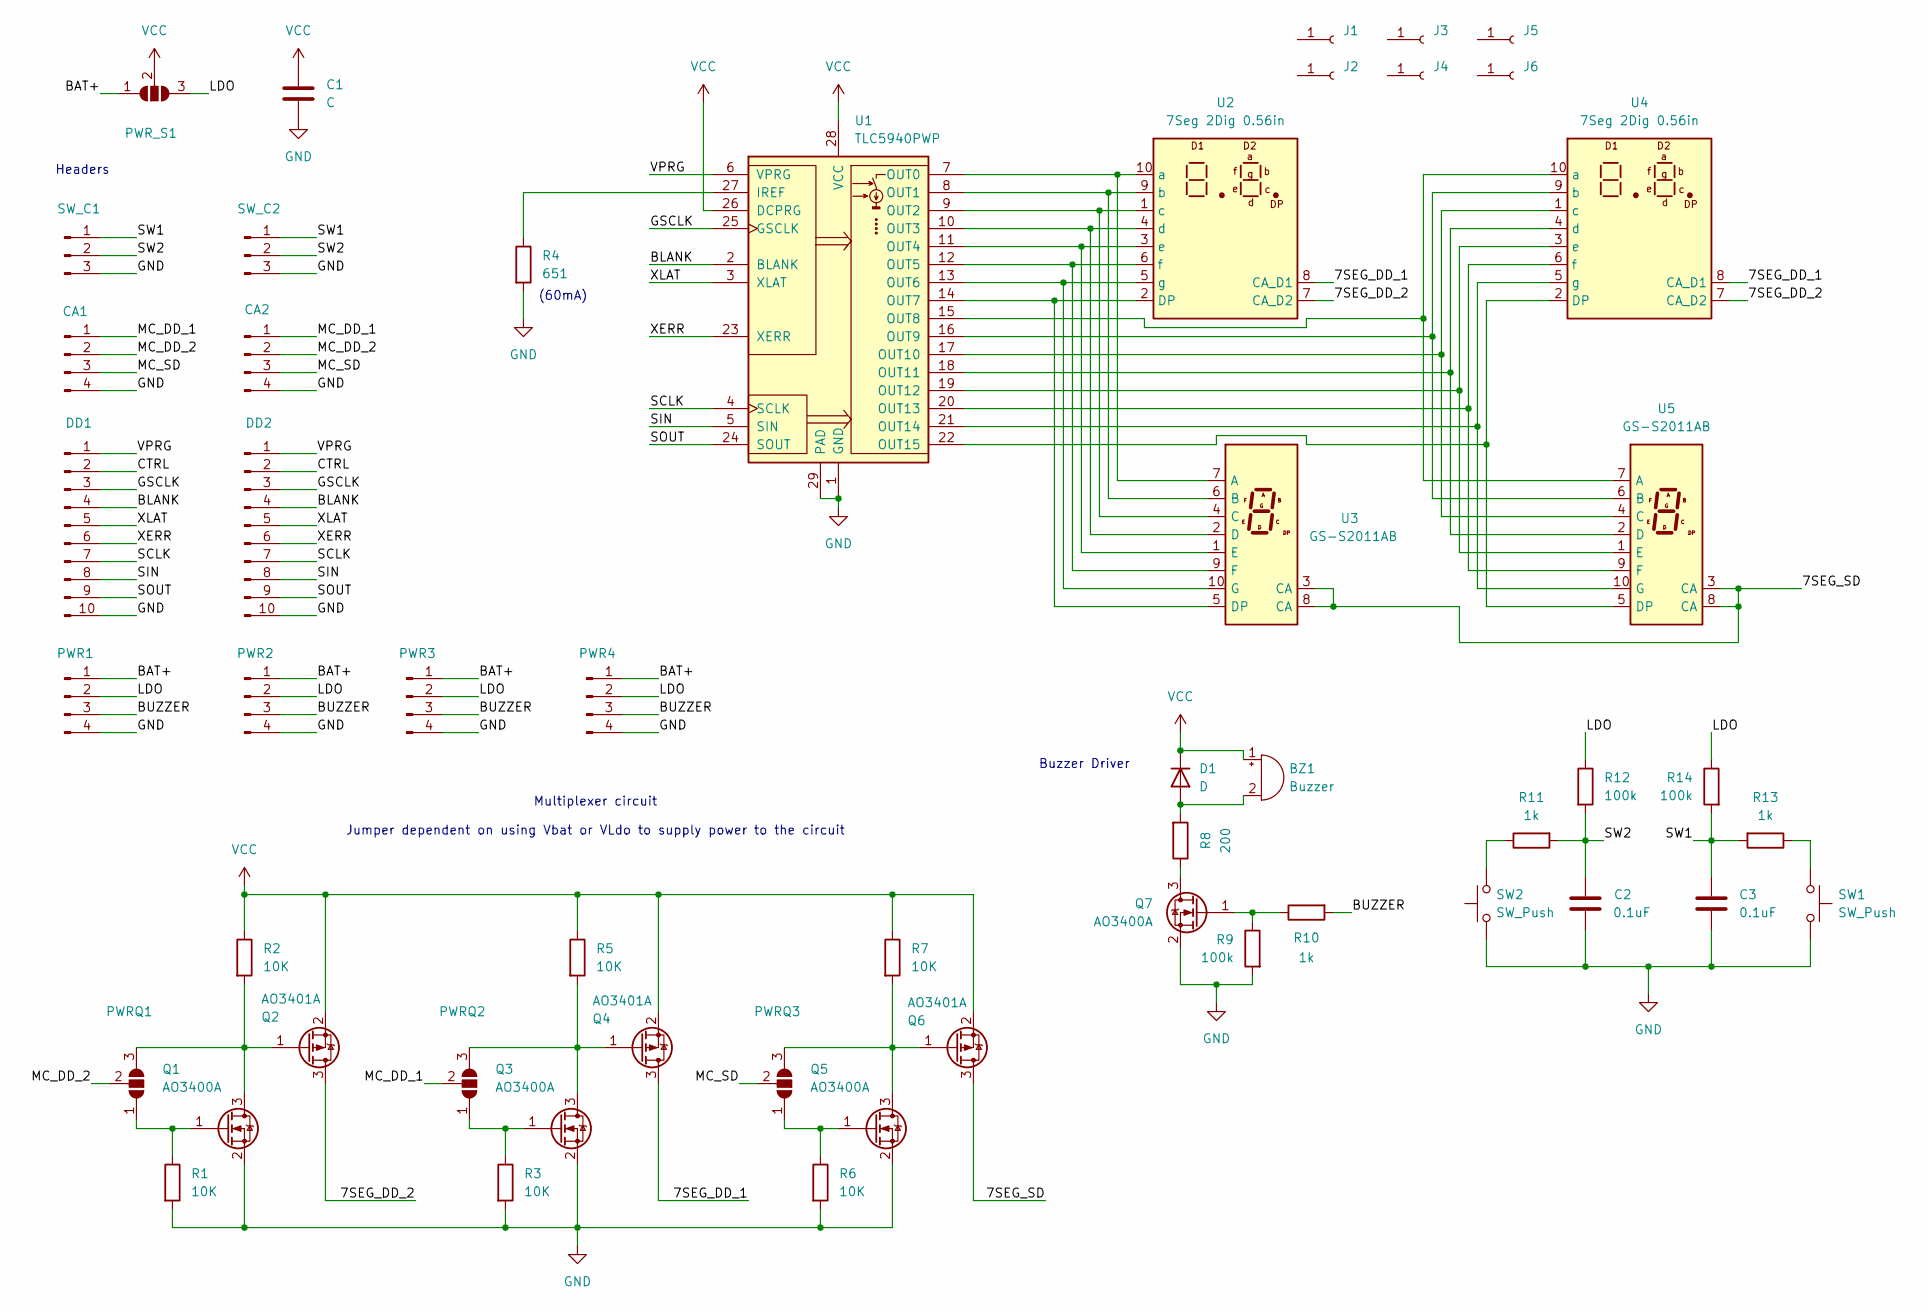
[picture p35: schematic display-board.kicad_sch]

Parts:
BZ1: Buzzer; Buzzer_TDK_PS1240P02BT_D12.2mm_H6.5mm
C1: C; C_0603_1608Metric_Pad1.08x0.95mm_HandSolder
C2, C3: 0.1uF; C_0805_2012Metric_Pad1.18x1.45mm_HandSolder
CA1, CA2: Conn_01x04_Pin; PinHeader_1x04_P1.27mm_Vertical
D1: D; D_SOD-323_HandSoldering
DD1, DD2: Conn_01x10_Pin; PinSocket_1x10_P1.27mm_Vertical
J1, J2, J3, J4, J5, J6: Conn_01x01_Socket; MountingHole_2mm
PWR1, PWR2, PWR3, PWR4: Conn_01x04_Pin; PinHeader_1x04_P1.27mm_Vertical
PWRQ1, PWRQ2, PWRQ3: SolderJumper_3_Open; SolderJumper-3_P1.3mm_Open_RoundedPad1.0x1.5mm_NumberLabels
PWR_S1: SolderJumper_3_Open; SolderJumper-3_P1.3mm_Open_RoundedPad1.0x1.5mm_NumberLabels
Q1, Q3, Q5, Q7: AO3400A; SOT-23
Q2, Q4, Q6: AO3401A; SOT-23
R1, R2, R3, R5, R6, R7: 10K; R_0603_1608Metric_Pad0.98x0.95mm_HandSolder
R4: 651; R_0603_1608Metric_Pad0.98x0.95mm_HandSolder
R8: 200; R_0603_1608Metric_Pad0.98x0.95mm_HandSolder
R9, R12, R14: 100k; R_0603_1608Metric_Pad0.98x0.95mm_HandSolder
R10, R11, R13: 1k; R_0603_1608Metric_Pad0.98x0.95mm_HandSolder
SW1, SW2: SW_Push; Button_12x12x7.3
SW_C1, SW_C2: Conn_01x03_Pin; PinHeader_1x03_P1.27mm_Vertical
U1: TLC5940PWP; HTSSOP-28-1EP_4.4x9.7mm_P0.65mm_EP3.4x9.5mm_Mask2.4x6.17mm_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
U2, U4: 7Seg 2Dig 0.56in; 7Seg 0.56In Double
U3, U5: GS-S2011AB; GS-2011AB

Connections:
/7SEG_DD_1: Q4.3 (D), U2.8 (CA_D1), U4.8 (CA_D1)
/7SEG_DD_2: Q2.3 (D), U2.7 (CA_D2), U4.7 (CA_D2)
/7SEG_SD: Q6.3 (D), U3.3 (CA), U3.8 (CA), U5.3 (CA), U5.8 (CA)
/BAT+: PWR1.1, PWR2.1, PWR3.1, PWR4.1, PWR_S1.1 (A); also elsewhere on the board
/BLANK: DD1.4, DD2.4, U1.2 (BLANK)
/BUZZER: PWR1.3, PWR2.3, PWR3.3, PWR4.3, R10.2
/CTRL: DD1.2, DD2.2; also elsewhere on the board
/GSCLK: DD1.3, DD2.3, U1.25 (GSCLK)
/LDO: PWR1.2, PWR2.2, PWR3.2, PWR4.2, PWR_S1.3 (B), R12.1, R14.1; also elsewhere on the board
/MC_DD_1: CA1.1, CA2.1, PWRQ2.2 (C)
/MC_DD_2: CA1.2, CA2.2, PWRQ1.2 (C)
/MC_SD: CA1.3, CA2.3, PWRQ3.2 (C)
/SCLK: DD1.7, DD2.7, U1.4 (SCLK)
/SIN: DD1.8, DD2.8, U1.5 (SIN)
/SOUT: DD1.9, DD2.9, U1.24 (SOUT)
/SW1: C3.1, R13.2, R14.2, SW_C1.1, SW_C2.1
/SW2: C2.1, R11.2, R12.2, SW_C1.2, SW_C2.2
/VPRG: DD1.1, DD2.1, U1.6 (VPRG)
/XERR: DD1.6, DD2.6, U1.23 (XERR)
/XLAT: DD1.5, DD2.5, U1.3 (XLAT)
GND: C1.2, C2.2, C3.2, CA1.4, CA2.4, DD1.10, DD2.10, PWR1.4, PWR2.4, PWR3.4, PWR4.4, Q1.2 (S), Q3.2 (S), Q5.2 (S), Q7.2 (S), R1.2, R3.2, R4.2, R6.2, R9.2, SW1.2, SW2.1, SW_C1.3, SW_C2.3, U1.1 (GND), U1.29 (PAD); also elsewhere on the board
unnamed: BZ1.2 (+), D1.2 (A), R8.2
unnamed: PWRQ1.1 (A), Q1.1 (G), R1.1
unnamed: PWRQ1.3 (B), Q1.3 (D), Q2.1 (G), R2.2
unnamed: PWRQ2.1 (A), Q3.1 (G), R3.1
unnamed: PWRQ2.3 (B), Q3.3 (D), Q4.1 (G), R5.2
unnamed: PWRQ3.1 (A), Q5.1 (G), R6.1
unnamed: PWRQ3.3 (B), Q5.3 (D), Q6.1 (G), R7.2
unnamed: Q7.3 (D), R8.1
unnamed: Q7.1 (G), R9.1, R10.1
unnamed: R11.1, SW2.2
unnamed: R13.1, SW1.1
unnamed: R4.1, U1.27 (IREF)
unnamed: U1.7 (OUT0), U2.10 (a), U3.7 (A)
unnamed: U1.8 (OUT1), U2.9 (b), U3.6 (B)
unnamed: U1.9 (OUT2), U2.1 (c), U3.4 (C)
unnamed: U1.10 (OUT3), U2.4 (d), U3.2 (D)
unnamed: U1.11 (OUT4), U2.3 (e), U3.1 (E)
unnamed: U1.12 (OUT5), U2.6 (f), U3.9 (F)
unnamed: U1.13 (OUT6), U2.5 (g), U3.10 (G)
unnamed: U1.14 (OUT7), U2.2 (DP), U3.5 (DP)
unnamed: U1.15 (OUT8), U4.10 (a), U5.7 (A)
unnamed: U1.16 (OUT9), U4.9 (b), U5.6 (B)
unnamed: U1.17 (OUT10), U4.1 (c), U5.4 (C)
unnamed: U1.18 (OUT11), U4.4 (d), U5.2 (D)
unnamed: U1.19 (OUT12), U4.3 (e), U5.1 (E)
unnamed: U1.20 (OUT13), U4.6 (f), U5.9 (F)
unnamed: U1.21 (OUT14), U4.5 (g), U5.10 (G)
unnamed: U1.22 (OUT15), U4.2 (DP), U5.5 (DP)
VCC: BZ1.1 (-), C1.1, D1.1 (K), PWR_S1.2 (C), Q2.2 (S), Q4.2 (S), Q6.2 (S), R2.1, R5.1, R7.1, U1.26 (DCPRG), U1.28 (VCC)

Notes on the sheet:
Headers
(60mA)
Buzzer Driver
Multiplexer circuit Jumper dependent on using Vbat or VLdo to supply power to the circuit

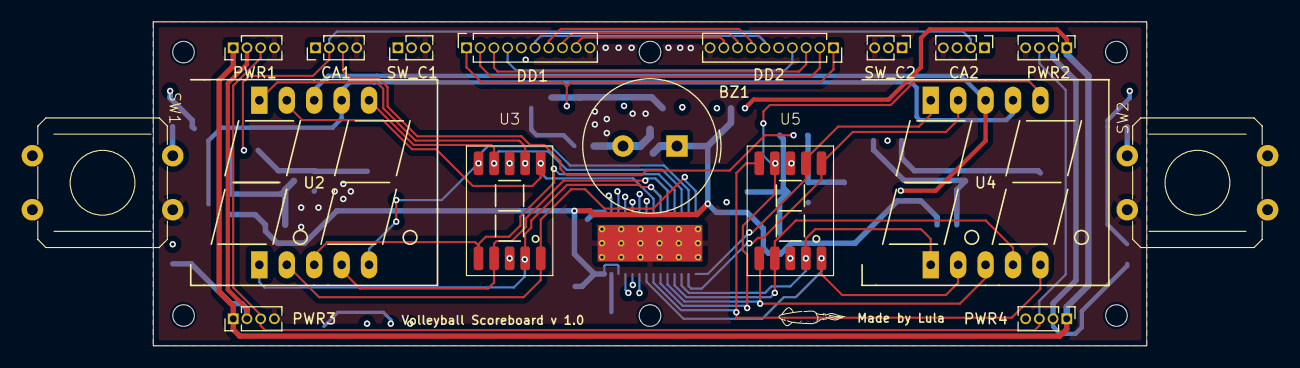
[picture p36: board hardware/pcb/v1.0/display-board/display-board.kicad_pcb from above]

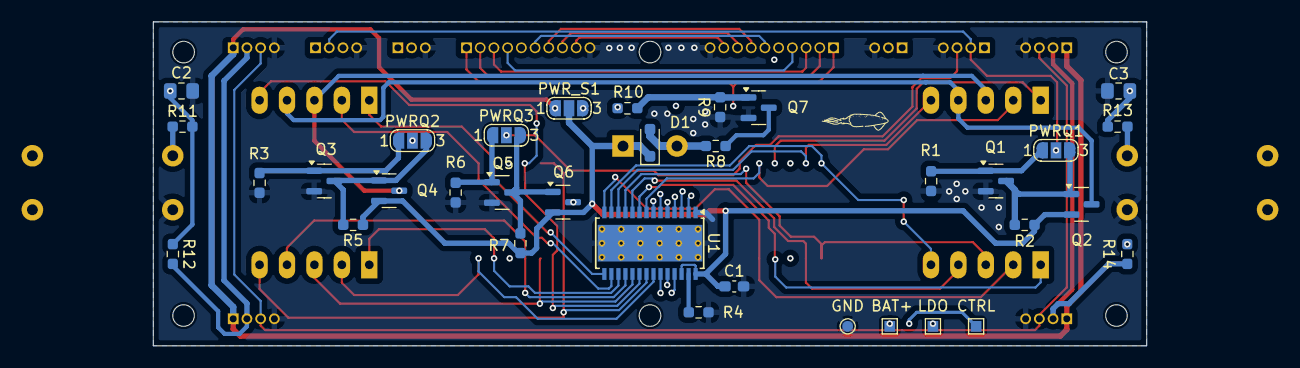
[picture p37: board hardware/pcb/v1.0/display-board/display-board.kicad_pcb from below]

Board: 4 copper layers, 92.0 x 30.0 mm, 57 parts (34 on the bottom side), 50 nets.

Other parts of the board:
BAT+: TestPoint_Pad_1.0x1.0mm
CTRL: TestPoint_Pad_1.0x1.0mm
GND: TestPoint_Pad_D1.0mm
LDO: TestPoint_Pad_1.0x1.0mm

Their connections:
/BAT+: BAT+.1; also elsewhere on the board
/CTRL: CTRL.1; also elsewhere on the board
/LDO: LDO.1; also elsewhere on the board
GND: GND.1; also elsewhere on the board
