arcticlula/Netscore/hardware/pcb/v1.0/main-board/main-board.kicad_pcb

## KiCad design hardware/pcb/v1.0/main-board/main-board.kicad_pcb (2025-01-12, an earlier design)

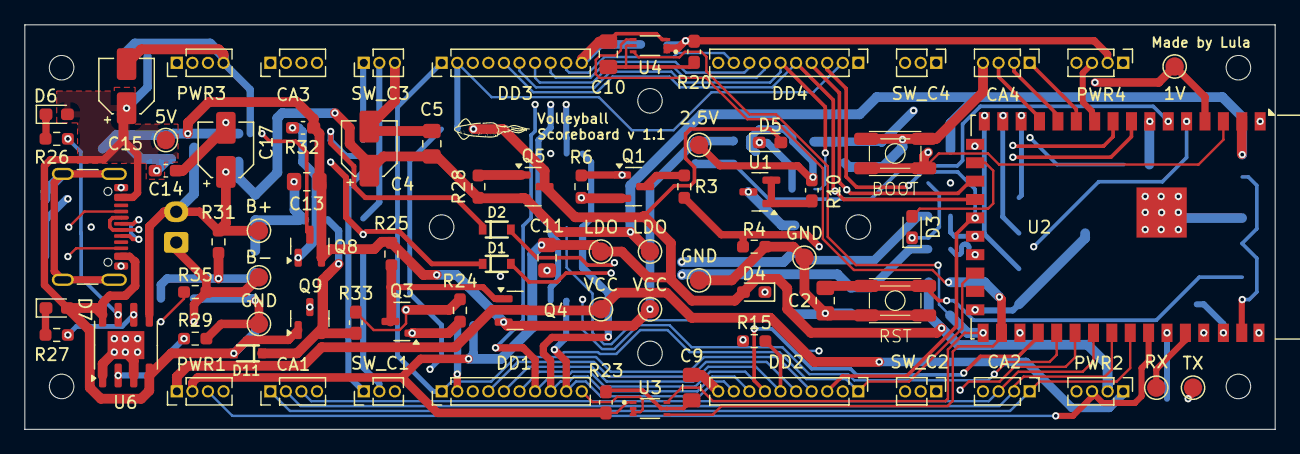
[picture p38: board hardware/pcb/v1.0/main-board/main-board.kicad_pcb from above]

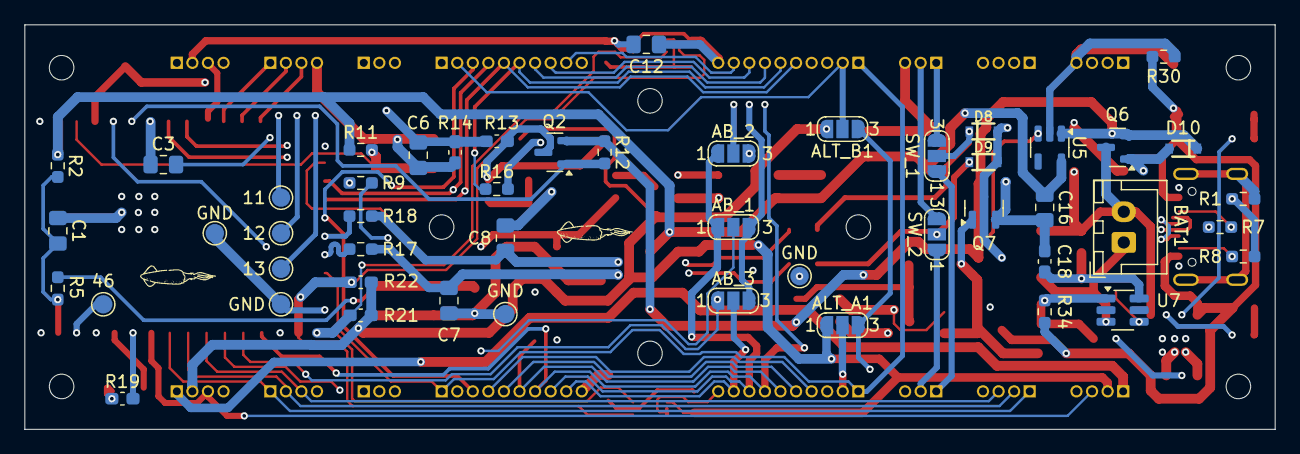
[picture p39: board hardware/pcb/v1.0/main-board/main-board.kicad_pcb from below]

Board: 4 copper layers, 102.0 x 33.0 mm, 137 parts (50 on the bottom side), 87 nets.

Parts:
1V, 2.5V, 5V, 11, 12, 13, 46: TestPoint_Alt; TestPoint_Pad_D1.5mm
AB_1, AB_2, AB_3: SolderJumper_3_Open; SolderJumper-3_P1.3mm_Open_RoundedPad1.0x1.5mm_NumberLabels
ALT_A1: SolderJumper_3_Open; SolderJumper-3_P1.3mm_Open_RoundedPad1.0x1.5mm_NumberLabels
ALT_B1: SolderJumper_3_Open; SolderJumper-3_P1.3mm_Open_RoundedPad1.0x1.5mm_NumberLabels
B+: TestPoint_Alt; TestPoint_Pad_D1.5mm
B-: TestPoint_Alt; TestPoint_Pad_D1.5mm
BAT1: Conn_01x02_Pin; JST_XH_B2B-XH-A_1x02_P2.50mm_Vertical
BOOT: SW_Push; Button_3x4x2.5
C1, C13, C16: 1uF; C_0805_2012Metric_Pad1.18x1.45mm_HandSolder
C2, C3, C5, C6, C9, C10, C11, C12: 0.1uF; C_0805_2012Metric_Pad1.18x1.45mm_HandSolder
C4, C15, C17: 10uF; CP_Elec_4x5.3
C7, C8: C; C_0805_2012Metric_Pad1.18x1.45mm_HandSolder
C14, C18: 100nF; C_0603_1608Metric_Pad1.08x0.95mm_HandSolder
CA1, CA2, CA3, CA4: Conn_01x04_Pin; PinHeader_1x04_P1.27mm_Vertical
D1, D2, D10: BAT20JFILM; SOD-323
D3, D4, D5, D6, D7: LED; LED_0603_1608Metric_Pad1.05x0.95mm_HandSolder
D8, D9, D11: BAT20J; SOD-323
DD1, DD2, DD3, DD4: Conn_01x10_Pin; PinHeader_1x10_P1.27mm_Vertical
GND: TestPoint_Alt; TestPoint_Pad_D1.5mm
GND#2, GND#3, GND#4, GND#5, GND#6, GND#7: TestPoint_Alt; TestPoint_Pad_D1.5mm
H1, H2, H3, H4, H5, H6, H7, H8: MountingHole; MountingHole_2mm
J1: USB_C_Receptacle_USB2.0_16P; USB_C_Receptacle_GCT_USB4105-xx-A_16P_TopMnt_Horizontal
LDO: TestPoint_Alt; TestPoint_Pad_D1.5mm
LDO#2: TestPoint_Alt; TestPoint_Pad_D1.5mm
PWR1, PWR2, PWR3, PWR4: Conn_01x04_Pin; PinHeader_1x04_P1.27mm_Vertical
Q1, Q2, Q4, Q5, Q6, Q8, Q9: AO3401A; SOT-23
Q3, Q7: AO3400A; SOT-23
R1, R5, R17, R18: 0; R_0603_1608Metric_Pad0.98x0.95mm_HandSolder
R2, R6, R11: 10k; R_0603_1608Metric_Pad0.98x0.95mm_HandSolder
R3, R4, R29: R; R_0603_1608Metric_Pad0.98x0.95mm_HandSolder
R7, R8: 5.1K; R_0603_1608Metric_Pad0.98x0.95mm_HandSolder
R9, R15, R16, R26, R27: 2.2K; R_0603_1608Metric_Pad0.98x0.95mm_HandSolder
R10, R13, R14: R; C_0603_1608Metric_Pad1.08x0.95mm_HandSolder
R12, R24, R25, R28, R34: 1M; R_0603_1608Metric_Pad0.98x0.95mm_HandSolder
R19: 499; C_0603_1608Metric_Pad1.08x0.95mm_HandSolder
R20, R23: 1k; C_0603_1608Metric_Pad1.08x0.95mm_HandSolder
R21, R22: 4.7k; C_0603_1608Metric_Pad1.08x0.95mm_HandSolder
R30: 10K; R_0603_1608Metric_Pad0.98x0.95mm_HandSolder
R31: 100; R_0603_1608Metric_Pad0.98x0.95mm_HandSolder
R32, R33: 1M; C_0603_1608Metric_Pad1.08x0.95mm_HandSolder
R35: 2K; R_0603_1608Metric_Pad0.98x0.95mm_HandSolder
RST: SW_Push; Button_3x4x2.5
RX: TestPoint_Alt; TestPoint_Pad_D1.5mm
SW_1, SW_2: SolderJumper_3_Open; SolderJumper-3_P1.3mm_Open_RoundedPad1.0x1.5mm_NumberLabels
SW_C1, SW_C2, SW_C3, SW_C4: Conn_01x03_Pin; PinHeader_1x03_P1.27mm_Vertical
TX: TestPoint_Alt; TestPoint_Pad_D1.5mm
U1: TL431DBZ; SOT-23
U2: ESP32-S2-WROVER-I; ESP32-S2-WROVER
U3, U4: BH1750FVI-TR; XDCR_BH1750FVI-TR
U5: AP2112K-3.3; SOT-23-5
U6: TP4056; SOIC-8-1EP_3.9x4.9mm_P1.27mm_EP2.29x3mm
U7: FS312MH; SOT-23-6_Handsoldering
VCC: TestPoint_Alt; TestPoint_Pad_D1.5mm
VCC#2: TestPoint_Alt; TestPoint_Pad_D1.5mm

Connections:
+BATT: B+.1, BAT1.2, C17.1, Q1.2 (S), Q6.3 (D), R6.1, R31.1, U6.5 (BAT)
-BATT: B-.1, BAT1.1, R35.1, U7.3 (BAT-)
/1V: 1V.1, C6.1, R13.2, R14.2, U2.4 (IO01)
/2.5V: 2.5V.1, Q2.3 (D), R10.1, R13.1
/ADC_BAT_EN: C3.1, U2.7 (IO04)
/ADC_BAT_V: R3.2, R4.1, U2.5 (IO02)
/ADC_VREF_EN: Q2.1 (G), R12.2, U2.6 (IO03)
/ALT_A: ALT_A1.2 (C), DD1.2, DD2.2
/ALT_B: ALT_B1.2 (C), DD3.2, DD4.2
/BLANK: DD1.4, DD2.4, DD3.4, DD4.4, U2.19 (IO16)
/BUZZER_A: PWR1.3, PWR2.3, U2.36 (IO42)
/BUZZER_B: PWR3.3, PWR4.3, U2.10 (IO07)
/CTRL: ALT_A1.3 (B), ALT_B1.3 (B), U2.32 (IO38)
/EN: C1.1, R2.2, R5.1, U2.41 (EN)
/GPIO11: 11.1, U2.14 (IO11)
/GPIO12: 12.1, U2.15 (IO12)
/GPIO13: 13.1, U2.16 (IO13)
/GPIO46: 46.1, U2.40 (IO46)
/GSCLK: DD1.3, DD2.3, DD3.3, DD4.3, U2.21 (IO18)
/LDO_CTRL_EN: Q5.1 (G), R28.2
/LDO_EN: Q8.3 (D), U5.3 (EN)
/LDO_LATCH: Q9.3 (D), U2.39 (IO45)
/MC_DD_1_A: CA1.1, CA2.1, U2.35 (IO41)
/MC_DD_1_B: CA3.1, CA4.1, U2.11 (IO08)
/MC_DD_2_A: CA1.2, CA2.2, U2.34 (IO40)
/MC_DD_2_B: CA3.2, CA4.2, U2.12 (IO09)
/MC_SD_A: CA1.3, CA2.3, U2.33 (IO39)
/MC_SD_B: CA3.3, CA4.3, U2.13 (IO10)
/MISO(SOUT): AB_2.3 (B), AB_3.1 (A), U2.31 (IO37)
/MOSI(SIN): AB_1.2 (C), U2.29 (IO35)
/SCL: R21.1, U2.27 (IO33), U3.6 (SCL), U4.6 (SCL)
/SCLK: DD1.7, DD2.7, DD3.7, DD4.7, U2.30 (IO36)
/SDA: R22.1, U2.28 (IO34), U3.4 (SDA), U4.4 (SDA)
/SIN_A: AB_1.1 (A), AB_2.1 (A), DD1.8, DD2.8
/SIN_B: AB_1.3 (B), AB_3.3 (B), DD3.8, DD4.8
/SOUT_A: AB_3.2 (C), DD1.9, DD2.9
/SOUT_B: AB_2.2 (C), DD3.9, DD4.9
/SW1: D2.C, D8.C, SW_1.2 (C)
/SW1_A: SW_1.1 (A), SW_C1.1, SW_C2.1
/SW1_B: SW_1.3 (B), SW_C3.1, SW_C4.1
/SW2: D1.C, D9.C, SW_2.2 (C)
/SW2_A: SW_2.1 (A), SW_C1.2, SW_C2.2
/SW2_B: SW_2.3 (B), SW_C3.2, SW_C4.2
/U0RXD: RX.1, U2.38 (RXD0)
/U0TXD: R19.2, TX.1
/USB_D+: C8.1, J1.A6 (D+), J1.B6 (D+), R18.2
/USB_D-: C7.1, J1.A7 (D-), J1.B7 (D-), R17.2
/VCC_CTRL: PWR1.1, PWR2.1, PWR3.1, PWR4.1, Q4.3 (D), VCC.1
/VCC_CTRL_EN: Q3.1 (G), R24.1, U2.17 (IO14)
/VPRG: DD1.1, DD2.1, DD3.1, DD4.1, U2.24 (IO21)
/XERR_A: DD1.6, DD2.6, R15.1
/XERR_B: DD3.6, DD4.6, R16.1
/XLAT: DD1.5, DD2.5, DD3.5, DD4.5, U2.20 (IO17)
GND: BOOT.1, C1.2, C2.1, C4.2, C5.1, C6.2, C7.2, C8.2, C9.1, C10.1, C11.1, C12.1, C13.2, C14.2, C15.2, C16.2, C17.2, C18.2, CA1.4, CA2.4, CA3.4, CA4.4, DD1.10, DD2.10, DD3.10, DD4.10, GND.1, GND#2.1, GND#3.1, GND#4.1, GND#5.1, GND#6.1, GND#7.1, J1.A1 (GND), J1.A12 (GND), J1.B1 (GND), J1.B12 (GND), PWR1.4, PWR2.4, PWR3.4, PWR4.4, Q3.2 (S), Q7.2 (S), R1.1, R4.2, R7.1, R8.1, R9.2, R14.1, R24.2, R29.2, R30.2, R33.2, R34.2, RST.2, SW_C1.3, SW_C2.3, SW_C3.3, SW_C4.3, U1.3 (A), U2.1 (GND), U2.26 (GND), U2.42 (GND), U2.43 (GND), U3.2 (ADDR), U3.3 (GND), U4.3 (GND), U5.2 (GND), U6.1 (TEMP), U6.3 (GND), U6.9 (PP), U7.1 (GND)
LDO: C4.1, C5.2, C16.1, LDO#2.1, Q5.2 (S), R2.1, R11.1, R28.1, U2.2 (3V3), U5.5 (VOUT)
LDO_CTRL: ALT_A1.1 (A), ALT_B1.1 (A), C11.2, C12.2, D4.2 (A), D5.2 (A), LDO.1, PWR1.2, PWR2.2, PWR3.2, PWR4.2, Q5.3 (D), R20.2, R21.2, R22.2, R23.2, U3.1 (VCC), U4.1 (VCC), U4.2 (ADDR)
unnamed: C2.2, R5.2, RST.1
unnamed: D3.2 (A), U2.18 (IO15)
unnamed: D3.1 (K), R9.1
unnamed: D4.1 (K), R15.2
unnamed: D5.1 (K), R16.2
unnamed: D6.1 (K), R26.1
unnamed: D7.1 (K), R27.1
unnamed: J1.A5 (CC1), R7.2
unnamed: J1.B5 (CC2), R8.2
unnamed: J1.S1 (SHIELD), R1.2
unnamed: Q1.3 (D), R3.1
unnamed: C3.2, Q1.1 (G), R6.2
unnamed: Q3.3 (D), Q4.1 (G), R25.2
unnamed: D8.A, D9.A, Q7.3 (D), Q8.1 (G), R32.2
unnamed: D11.C, Q7.1 (G), Q9.2 (S), R33.1
unnamed: R10.2, U1.1 (K), U1.2 (REF)
unnamed: BOOT.2, R11.2, U2.3 (IO00)
unnamed: D1.A, U2.8 (IO05)
unnamed: D2.A, U2.9 (IO06)
unnamed: R19.1, U2.37 (TXD0)
unnamed: R17.1, U2.23 (USB_D+)
unnamed: R18.1, U2.22 (USB_D-)
unnamed: C9.2, R23.1, U3.5 (DVI)
unnamed: C10.2, R20.1, U4.5 (DVI)
unnamed: R29.1, U6.2 (PROG)
unnamed: R26.2, U6.7 (~CHRG)
unnamed: R27.2, U6.6 (~STDBY)
unnamed: R35.2, U7.4 (CS)
unnamed: C18.1, R31.2, U7.6 (VCC)
VBUS: 5V.1, C14.1, C15.1, D6.2 (A), D7.2 (A), D10.A, D11.A, J1.A4 (VBUS), J1.A9 (VBUS), J1.B4 (VBUS), J1.B9 (VBUS), Q6.1 (G), Q9.1 (G), R30.1, R34.1, U6.4 (VCC), U6.8 (CE)
VCC: C13.1, D10.C, Q2.2 (S), Q4.2 (S), Q6.2 (S), Q8.2 (S), R12.1, R25.1, R32.1, U5.1 (VIN), VCC#2.1
