arcticlula/Netscore/software/v3.0/main-unit/main/display/tlc5951/tlc5951.cpp

#include "tlc5951.h"

#include <math.h>
#include <string.h>

#include "definitions.h"
#include "display/display_definitions.h"
#include "display/display_helper.h"
#include "driver/ledc.h"
#include "esp_timer.h"
#include "freertos/FreeRTOS.h"
#include "freertos/semphr.h"
#include "freertos/task.h"
#include "misc.h"
#include "settings/settings.h"
#include "spi/spi.h"

SemaphoreHandle_t spi_mutex = NULL;

gpio_num_t gssin_pin;
gpio_num_t dcsin_pin;
gpio_num_t sclk_pin;
gpio_num_t xlat_pin;
gpio_num_t blank_pin;
gpio_num_t gsclk_pin;

volatile uint8_t current_mux = MUX_1;
volatile uint8_t target_mux = MUX_1;
volatile uint8_t active_buffer = 0;
volatile uint8_t inactive_buffer = 1;

uint8_t mux[] = {MUX_1_PIN, MUX_2_PIN, MUX_3_PIN, MUX_4_PIN};

// Dynamic display layouts loaded from settings
// The float segment_a/b have been removed.

gpio_num_t mux_1, mux_2, mux_3, mux_4;

/** GS Data Buffer
 * 2 buffers (double buffering)
 * MUX_NUM multiplexing steps
 * GS_BYTES_TOTAL bytes per step (36 bytes * NUM_TLCS)
 */
uint8_t gs_buffers[2][MUX_NUM][GS_BYTES_TOTAL];

static esp_timer_handle_t display_timer;
static void (*user_callback)() = NULL;

Tlc5951 Tlc;

void Tlc5951::init(uint8_t gssin, int dcsin, uint8_t sclk, uint8_t xlat, uint8_t blank, uint8_t gsclk) {
  if (spi_mutex == NULL) {
    spi_mutex = xSemaphoreCreateMutex();
  }

  gssin_pin = (gpio_num_t)gssin;
  dcsin_pin = (gpio_num_t)dcsin;
  sclk_pin = (gpio_num_t)sclk;
  xlat_pin = (gpio_num_t)xlat;
  blank_pin = (gpio_num_t)blank;
  gsclk_pin = (gpio_num_t)gsclk;

  // Initialize GPIO outputs
  gpio_reset_pin(xlat_pin);
  gpio_set_direction(xlat_pin, GPIO_MODE_OUTPUT);
  gpio_set_level(xlat_pin, LOW);

  gpio_reset_pin(blank_pin);
  gpio_set_direction(blank_pin, GPIO_MODE_OUTPUT);
  // TLC5951 BLANK is active LOW on this hardware (LOW = OFF). We start with outputs disabled.
  gpio_reset_pin(blank_pin);
  gpio_set_direction(blank_pin, GPIO_MODE_OUTPUT);
  gpio_set_level(blank_pin, LOW);

  // Initialize DCSIN to HIGH.
  // Because GSSCK and DCSCK are tied to the same SPI clock pin on this hardware,
  // the SPI transaction will clock 288 bits of whatever state DCSIN is currently at.
  // If DCSIN is LOW, the DC/BC registers fill with 0s and the 3ms auto-latch timeout
  // kills the output current completely. Setting it HIGH fills DC/BC with 1s (max brightness).
  //
  // On v3.0 the DCSIN chain was removed from the slot connector (dcsin < 0):
  // the display board straps its local DCSIN high on its own, so the main board
  // drives nothing here.
  if (dcsin >= 0) {
    gpio_reset_pin(dcsin_pin);
    gpio_set_direction(dcsin_pin, GPIO_MODE_OUTPUT);
    gpio_set_level(dcsin_pin, HIGH);
  }

  // Clear buffers
  clear();

  // Initialize SPI
  spi_init(sclk_pin, gssin_pin);

  // Initialize MUX pins
  init_mux((gpio_num_t)MUX_1_PIN, (gpio_num_t)MUX_2_PIN, (gpio_num_t)MUX_3_PIN, (gpio_num_t)MUX_4_PIN);

  // Set up GSCLK using LEDC
  ledc_timer_config_t gsclk_timer = {};
  gsclk_timer.speed_mode = LEDC_LOW_SPEED_MODE;
  gsclk_timer.timer_num = LEDC_TIMER_0;
  gsclk_timer.duty_resolution = LEDC_TIMER_1_BIT;
  gsclk_timer.freq_hz = 20000000;  // 20MHz GSCLK (Better stability for long cables)
  gsclk_timer.clk_cfg = LEDC_AUTO_CLK;
  ESP_ERROR_CHECK(ledc_timer_config(&gsclk_timer));

  ledc_channel_config_t gsclk_channel = {};
  gsclk_channel.speed_mode = LEDC_LOW_SPEED_MODE;
  gsclk_channel.channel = LEDC_CHANNEL_0;
  gsclk_channel.timer_sel = LEDC_TIMER_0;
  gsclk_channel.intr_type = LEDC_INTR_DISABLE;
  gsclk_channel.gpio_num = gsclk_pin;
  gsclk_channel.duty = 1;  // 50% duty cycle of 1-bit timer
  gsclk_channel.hpoint = 0;
  ESP_ERROR_CHECK(ledc_channel_config(&gsclk_channel));

  // Create update task timer
  const esp_timer_create_args_t periodic_timer_args = {
      .callback = &display_update_task,
      .arg = NULL,
      .dispatch_method = ESP_TIMER_TASK,
      .name = "display_update",
      .skip_unhandled_events = true};

  ESP_ERROR_CHECK(esp_timer_create(&periodic_timer_args, &display_timer));

  setGroupCalibration(sys_group_cal_r, sys_group_cal_g, sys_group_cal_b);
  set_brightness();
  // Start the timer to match the frame rate requirements
  uint64_t interval = (uint64_t)(1000000 / MUX_FRAME_RATE_HZ) / MUX_NUM;
  ESP_ERROR_CHECK(esp_timer_start_periodic(display_timer, interval));
  display_timer_started = true;
}

void Tlc5951::setUserCallback(void (*callback)()) {
  user_callback = callback;
}

void Tlc5951::clear(void) {
  // Only clear the inactive buffer — the active buffer is currently being read
  // by display_update_task via DMA and must not be modified mid-transfer.
  memset(gs_buffers[inactive_buffer], 0, sizeof(gs_buffers[inactive_buffer]));
}

void Tlc5951::setGroupChannel(uint8_t tlc_index, color_group_t group, uint8_t channel, uint8_t mux_idx, uint16_t value) {
  if (tlc_index >= NUM_TLCS || channel >= TLC_CHANNELS_PER_GROUP || mux_idx >= MUX_NUM) return;

  // The TLC5951 daisy-chain expects data for the LAST chip first.
  // So TLC 1 (SIDE_B) data comes first, then TLC 0 (SIDE_A).
  uint8_t shift_index = (NUM_TLCS - 1) - tlc_index;

  // Calculate the base pointer for this TLC's section of the buffer
  uint8_t *tlc_base = gs_buffers[inactive_buffer][mux_idx] + (shift_index * GS_BYTES_PER_TLC);

  // TLC5951 expects interleaved channels: B7, G7, R7, B6, G6, R6 ... B0, G0, R0
  uint8_t color_idx = 0;
  if (group == COLOR_B) color_idx = 0;
  else if (group == COLOR_G)
    color_idx = 1;
  else if (group == COLOR_R)
    color_idx = 2;

  // Calculate the channel's 12-bit slot index (0 to 23)
  uint8_t slot_index = (7 - channel) * 3 + color_idx;
  uint8_t *index12p = tlc_base + ((slot_index * 3) >> 1);

  if (slot_index & 1) {  // Odd index - starts in the middle of a byte
    *index12p = (*index12p & 0xF0) | (value >> 8);
    *(++index12p) = value & 0xFF;
  } else {  // Even index - starts clean
    *(index12p++) = value >> 4;
    *index12p = ((uint8_t)(value << 4)) | (*index12p & 0xF);
  }
}

void Tlc5951::setSegment(uint8_t side, uint8_t digit_index, uint8_t segment, uint16_t value) {
  if (side == SIDE_BOTH) {
    setSegment(SIDE_A, digit_index, segment, value);
    setSegment(SIDE_B, digit_index, segment, value);
    return;
  }

  if (display_mode == DISPLAY_MODE_A && side == SIDE_B) return;
  if (display_mode == DISPLAY_MODE_B && side == SIDE_A) return;

  uint8_t tlc_index = side;
  uint8_t mux_idx = 0;
  color_group_t color_group;
  uint8_t channel = segment;

  bool should_swap = sys_swap_teams;
  if (should_swap) {
    if (window != PLAY_SCR &&
        window != PLAY_WIN_SCR &&
        window != PLAY_MENU_SCR) {
      should_swap = false;
    }
  }

  if (should_swap) {
    switch (digit_index) {
      case POINTS_HOME_1:
        digit_index = POINTS_AWAY_1;
        break;
      case POINTS_HOME_2:
        digit_index = POINTS_AWAY_2;
        break;
      case POINTS_AWAY_1:
        digit_index = POINTS_HOME_1;
        break;
      case POINTS_AWAY_2:
        digit_index = POINTS_HOME_2;
        break;
      case SETS_HOME:
        digit_index = SETS_AWAY;
        break;
      case SETS_AWAY:
        digit_index = SETS_HOME;
        break;
    }
  }

  // Map flat logical digit index to TLC color group and MUX position
  if (digit_index <= POINTS_AWAY_2) {
    color_group = COLOR_R;
    mux_idx = digit_index;
  } else if (digit_index <= TIME_4) {
    color_group = COLOR_G;
    mux_idx = digit_index - TIME_1;
  } else if (digit_index <= SETS_AWAY) {
    color_group = COLOR_B;
    mux_idx = digit_index - SETS_HOME;
  } else {
    return;  // Invalid digit index
  }

  // Retrieve brightness offset using direct mapping
  uint8_t offset = (side == SIDE_A) ? sys_segment_a[digit_index] : sys_segment_b[digit_index];
  uint32_t corrected_value = (uint32_t)value * offset / 100;
  uint16_t final_value = get_gamma_corrected_value((uint16_t)corrected_value);

  setGroupChannel(tlc_index, color_group, channel, mux_idx, final_value);
}

void Tlc5951::setLed(uint8_t side, uint8_t led_id, uint16_t value) {
  if (side == SIDE_BOTH) {
    setLed(SIDE_A, led_id, value);
    setLed(SIDE_B, led_id, value);
    return;
  }

  if (display_mode == DISPLAY_MODE_A && side == SIDE_B) return;
  if (display_mode == DISPLAY_MODE_B && side == SIDE_A) return;

  bool should_swap = sys_swap_teams;
  if (should_swap) {
    if (window != PLAY_SCR &&
        window != PLAY_WIN_SCR &&
        window != PLAY_MENU_SCR) {
      should_swap = false;
    }
  }

  if (should_swap) {
    switch (led_id) {
      case LED_HOME_1:
        led_id = LED_AWAY_1;
        break;
      case LED_HOME_2:
        led_id = LED_AWAY_2;
        break;
      case LED_HOME_3:
        led_id = LED_AWAY_3;
        break;
      case LED_AWAY_1:
        led_id = LED_HOME_1;
        break;
      case LED_AWAY_2:
        led_id = LED_HOME_2;
        break;
      case LED_AWAY_3:
        led_id = LED_HOME_3;
        break;
      case BAR_LED_1:
        led_id = BAR_LED_2;
        break;
      case BAR_LED_2:
        led_id = BAR_LED_1;
        break;
      case BAR_LED_3:
        led_id = BAR_LED_4;
        break;
      case BAR_LED_4:
        led_id = BAR_LED_3;
        break;
    }
  }

  uint8_t channel = get_led_index(led_id);

  uint8_t offset = (side == SIDE_A) ? sys_misc_a[led_id] : sys_misc_b[led_id];
  uint32_t corrected_value = (uint32_t)value * offset / 100;
  uint16_t final_value = get_gamma_corrected_value((uint16_t)corrected_value);
  setGroupChannel(side, COLOR_B, channel, MUX_3, final_value);
}

void Tlc5951::setTestLed(uint8_t side, uint8_t led_id, uint16_t value) {
  if (side == SIDE_BOTH) {
    setTestLed(SIDE_A, led_id, value);
    setTestLed(SIDE_B, led_id, value);
    return;
  }

  uint8_t channel = get_led_index(led_id);

  if (display_mode == DISPLAY_MODE_A && side == SIDE_B) return;
  if (display_mode == DISPLAY_MODE_B && side == SIDE_A) return;

  uint8_t offset = (side == SIDE_A) ? sys_misc_a[led_id] : sys_misc_b[led_id];
  uint32_t corrected_value = (uint32_t)value * offset / 100;
  uint16_t final_value = get_gamma_corrected_value((uint16_t)corrected_value);
  uint8_t mux = (led_id == LED_TEST_1) ? MUX_3 : MUX_4;
  setGroupChannel(side, COLOR_B, channel, mux, final_value);
}

void Tlc5951::setTimeColon(uint8_t side, uint8_t digit_index, uint16_t value) {
  if (side == SIDE_BOTH) {
    setTimeColon(SIDE_A, digit_index, value);
    setTimeColon(SIDE_B, digit_index, value);
    return;
  }

  uint8_t channel = get_led_index(digit_index);

  if (display_mode == DISPLAY_MODE_A && side == SIDE_B) return;
  if (display_mode == DISPLAY_MODE_B && side == SIDE_A) return;

  uint8_t led_id = digit_index;  // time colon macro
  uint8_t offset = (side == SIDE_A) ? sys_misc_a[led_id] : sys_misc_b[led_id];
  uint32_t corrected_value = (uint32_t)value * offset / 100;
  uint16_t final_value = get_gamma_corrected_value((uint16_t)corrected_value);
  setGroupChannel(side, COLOR_B, channel, MUX_4, final_value);
}

void Tlc5951::setTimeColons(uint8_t side, uint16_t value_top, uint16_t value_bottom) {
  if (side == SIDE_BOTH) {
    setTimeColons(SIDE_A, value_top, value_bottom);
    setTimeColons(SIDE_B, value_top, value_bottom);
    return;
  }

  if (display_mode == DISPLAY_MODE_A && side == SIDE_B) return;
  if (display_mode == DISPLAY_MODE_B && side == SIDE_A) return;

  uint8_t offset_top = (side == SIDE_A) ? sys_misc_a[TIME_COLON_TOP] : sys_misc_b[TIME_COLON_TOP];
  uint8_t offset_bottom = (side == SIDE_A) ? sys_misc_a[TIME_COLON_BOTTOM] : sys_misc_b[TIME_COLON_BOTTOM];

  uint32_t corrected_top = (uint32_t)value_top * offset_top / 100;
  uint32_t corrected_bottom = (uint32_t)value_bottom * offset_bottom / 100;

  uint16_t final_value_top = get_gamma_corrected_value((uint16_t)corrected_top);
  uint16_t final_value_bottom = get_gamma_corrected_value((uint16_t)corrected_bottom);
  setGroupChannel(side, COLOR_B, get_led_index(TIME_COLON_TOP), MUX_4, final_value_top);
  setGroupChannel(side, COLOR_B, get_led_index(TIME_COLON_BOTTOM), MUX_4, final_value_bottom);
}

void Tlc5951::setBarLed(uint8_t side, uint8_t led_id, uint16_t value) {
  if (side == SIDE_BOTH) {
    setBarLed(SIDE_A, led_id, value);
    setBarLed(SIDE_B, led_id, value);
    return;
  }

  uint8_t channel = get_led_index(led_id);

  if (display_mode == DISPLAY_MODE_A && side == SIDE_B) return;
  if (display_mode == DISPLAY_MODE_B && side == SIDE_A) return;

  uint8_t offset = (side == SIDE_A) ? sys_misc_a[led_id] : sys_misc_b[led_id];
  uint32_t corrected_value = (uint32_t)value * offset / 100;
  uint16_t final_value = get_gamma_corrected_value((uint16_t)corrected_value);
  setGroupChannel(side, COLOR_B, channel, MUX_4, final_value);
}

void Tlc5951::setAll(uint16_t value) {
  uint16_t final_value = get_gamma_corrected_value(value);
  uint8_t first_byte = final_value >> 4;
  uint8_t second_byte = (final_value << 4) | (final_value >> 8);
  uint8_t third_byte = (uint8_t)final_value;

  for (int m = 0; m < MUX_NUM; m++) {
    uint8_t *p = gs_buffers[inactive_buffer][m];
    while (p < gs_buffers[inactive_buffer][m] + GS_BYTES_TOTAL) {
      *p++ = first_byte;
      *p++ = second_byte;
      *p++ = third_byte;
    }
  }
}

uint16_t Tlc5951::get(uint8_t tlc_index, color_group_t group, uint8_t channel) {
  if (tlc_index >= NUM_TLCS || channel >= TLC_CHANNELS_PER_GROUP) return 0;

  uint8_t shift_index = (NUM_TLCS - 1) - tlc_index;
  uint8_t *tlc_base = gs_buffers[inactive_buffer][target_mux] + (shift_index * GS_BYTES_PER_TLC);

  uint8_t color_idx = 0;
  if (group == COLOR_B) color_idx = 0;
  else if (group == COLOR_G)
    color_idx = 1;
  else if (group == COLOR_R)
    color_idx = 2;

  uint8_t slot_index = (7 - channel) * 3 + color_idx;
  uint8_t *index12p = tlc_base + ((slot_index * 3) >> 1);

  return (slot_index & 1) ? (((uint16_t)(*index12p & 15)) << 8) | *(index12p + 1) : (((uint16_t)(*index12p)) << 4) | ((*(index12p + 1) & 0xF0) >> 4);
}

/**
 * Build a 36-byte (288-bit) DC frame for the Common Shift Register (via GSSIN).
 * This layout allows writing to DC/BC/FC registers through the grayscale port.
 *
 * TLC5951 Common Register layout (Table 9 from datasheet):
 *   Bits 287-199 : UD / Unused (89 bits)
 *   Bits 198-192 : FC (Function Control) (7 bits)
 *   Bits 191-184 : BC_B (8 bits)
 *   Bits 183-176 : BC_G (8 bits)
 *   Bits 175-168 : BC_R (8 bits)
 *   Bits 167-0   : DC (Dot Correction) (168 bits = 21 bytes)
 */
static void build_dc_frame(uint8_t *buf, uint8_t fc, uint8_t bc_r, uint8_t bc_g, uint8_t bc_b) {
  // Clear the first 15 bytes (Unused, FC, BC region)
  memset(buf, 0x00, 15);

  // Set the remaining 21 bytes to 0xFF (DC data = max for all 24 channels)
  memset(buf + 15, 0xFF, 21);

  // buf[11] bit 7 is Bit 199. Bits 6..0 are FC (198..192).
  buf[11] = fc & 0x7F;

  // buf[12] = BC_B (191..184)
  buf[12] = bc_b;

  // buf[13] = BC_G (183..176)
  buf[13] = bc_g;

  // buf[14] = BC_R (175..168)
  buf[14] = bc_r;
}

void Tlc5951::setFunctionControl(uint8_t fc) {
  if (fc_data == fc) return;
  fc_data = fc;
  updateDcData();
}

void Tlc5951::setGlobalBrightness(uint8_t level) {
  if (level > 100) level = 100;
  global_level = level;

  uint32_t target_bc = 0;
  if (level > 0) {
    // Logarithmic-like perceived brightness curve (exponential mapping of physical current).
    // Using a gamma correction power curve with gamma = 2.5, mapping input level 1-100 to target BC 1-255.
    target_bc = 1 + (uint32_t)round(254.0 * pow((double)level / 100.0, 2.5));
  }

  // Apply group calibration (0-100%) to the 0-255 target BC
  bc_r_val = (target_bc * group_cal_r) / 100;
  bc_g_val = (target_bc * group_cal_g) / 100;
  bc_b_val = (target_bc * group_cal_b) / 100;

  updateDcData();
}

void Tlc5951::setGroupCalibration(uint8_t r, uint8_t g, uint8_t b) {
  group_cal_r = (r > 100) ? 100 : r;
  group_cal_g = (g > 100) ? 100 : g;
  group_cal_b = (b > 100) ? 100 : b;

  setGlobalBrightness(global_level);
}

void Tlc5951::setBrightnessControl(uint8_t bc_r, uint8_t bc_g, uint8_t bc_b) {
  // Directly set the BC values (bypassing global scaling)
  bc_r_val = bc_r;
  bc_g_val = bc_g;
  bc_b_val = bc_b;

  updateDcData();
}

void Tlc5951::updateDcData() {
  // Determine how many TLCs to shift based on slot detection
  int num_to_send = (slots == SIDE_BOTH) ? 2 : 1;

  const int total_bytes = GS_BYTES_PER_TLC * num_to_send;
  uint8_t dc_buf[GS_BYTES_TOTAL];
  memset(dc_buf, 0, sizeof(dc_buf));

  for (int t = 0; t < num_to_send; t++) {
    build_dc_frame(dc_buf + t * GS_BYTES_PER_TLC, fc_data, bc_r_val, bc_g_val, bc_b_val);
  }

  // --- Pause display updates ---
  esp_timer_stop(display_timer);  // Safe to call even if not running

  // Take the SPI mutex to avoid collisions with the display_update_task
  if (spi_mutex != NULL) {
    xSemaphoreTake(spi_mutex, portMAX_DELAY);
  }

  // Blank the display during the transfer
  gpio_set_level(blank_pin, LOW);

  // --- Start DC Write Sequence using GSSIN (Pin 11) ---
  gpio_set_level(xlat_pin, HIGH);
  esp_rom_delay_us(10);

  spi_send(dc_buf, total_bytes);

  gpio_set_level(xlat_pin, LOW);
  esp_rom_delay_us(10);

  gpio_set_level(xlat_pin, HIGH);
  esp_rom_delay_us(10);
  gpio_set_level(xlat_pin, LOW);
  esp_rom_delay_us(10);

  if (spi_mutex != NULL) {
    xSemaphoreGive(spi_mutex);
  }

  // --- Always restart the display timer ---
  // Unconditional restart eliminates the TOCTOU race where timer_was_active
  // could be false if a concurrent call had already stopped the timer, leaving
  // it permanently stopped. display_timer_started guards against premature
  // restarts during the init() sequence before the timer is first armed.
  if (display_timer_started) {
    uint64_t interval = (uint64_t)(1000000 / MUX_FRAME_RATE_HZ) / MUX_NUM;
    esp_timer_start_periodic(display_timer, interval);  // no-op if already running
  }
}
void swap_buffers() {
  active_buffer = !active_buffer;
  inactive_buffer = !inactive_buffer;
}

void display_logic_task(void *arg) {
  while (true) {
    if (user_callback) user_callback();
    swap_buffers();
    vTaskDelay((FRAME_TIME_MS) / portTICK_PERIOD_MS);
  }
}

IRAM_ATTR void display_update_task(void *arg) {
  // If the SPI bus is being used by updateDcData, skip this frame to prevent collisions
  if (spi_mutex != NULL) {
    if (xSemaphoreTake(spi_mutex, 0) != pdTRUE) {
      return;
    }
  }

  // 1. Turn off outputs (LOW = Blank ON)
  gpio_set_level(blank_pin, LOW);

  // Add dead-time to ensure PMOS transistors are fully OFF before switching MUX
  esp_rom_delay_us(50);

  // 2. Switch multiplexer hardware to the NEXT row
  target_mux = (target_mux + 1) % MUX_NUM;
  iterate_mux();

  // 3. Give the MUX PMOS transistors time to fully stabilize before we latch new data
  esp_rom_delay_us(50);

  // 4. Latch the data that was shifted in the PREVIOUS interrupt
  gpio_set_level(xlat_pin, HIGH);
  esp_rom_delay_us(10);
  gpio_set_level(xlat_pin, LOW);

  // 5. Turn on outputs for the new row (HIGH = ON)
  gpio_set_level(blank_pin, HIGH);

  // 5. Shift in GS data for the NEXT row (will be latched on next interrupt)
  uint8_t next_mux = (target_mux + 1) % MUX_NUM;

  if (slots == SIDE_BOTH) {
    spi_send(gs_buffers[active_buffer][next_mux], GS_BYTES_TOTAL);
  } else if (slots == SIDE_A || slots == SIDE_B) {
    // Send SIDE_A buffer (located at +GS_BYTES_PER_TLC) to the single connected display
    spi_send(gs_buffers[active_buffer][next_mux] + GS_BYTES_PER_TLC, GS_BYTES_PER_TLC);
  }

  if (spi_mutex != NULL) {
    xSemaphoreGive(spi_mutex);
  }
}

uint16_t get_gamma_corrected_value(uint16_t value) {
  if (value >= 4096) return 4095;
  return gamma_correction_vector[value];
}

void init_mux(uint8_t mux_1_pin, uint8_t mux_2_pin, uint8_t mux_3_pin, uint8_t mux_4_pin) {
  mux_1 = (gpio_num_t)mux_1_pin;
  mux_2 = (gpio_num_t)mux_2_pin;
  mux_3 = (gpio_num_t)mux_3_pin;
  mux_4 = (gpio_num_t)mux_4_pin;

  gpio_reset_pin(mux_1);
  gpio_set_direction(mux_1, GPIO_MODE_OUTPUT);
  gpio_set_level(mux_1, LOW);

  gpio_reset_pin(mux_2);
  gpio_set_direction(mux_2, GPIO_MODE_OUTPUT);
  gpio_set_level(mux_2, LOW);

  gpio_reset_pin(mux_3);
  gpio_set_direction(mux_3, GPIO_MODE_OUTPUT);
  gpio_set_level(mux_3, LOW);

  gpio_reset_pin(mux_4);
  gpio_set_direction(mux_4, GPIO_MODE_OUTPUT);
  gpio_set_level(mux_4, LOW);
}

void iterate_mux() {
  gpio_set_level(mux_1, target_mux == 0 ? HIGH : LOW);
  gpio_set_level(mux_2, target_mux == 1 ? HIGH : LOW);
  gpio_set_level(mux_3, target_mux == 2 ? HIGH : LOW);
  gpio_set_level(mux_4, target_mux == 3 ? HIGH : LOW);
}
