arcticlula/Netscore/software/v2.0 Prototype/main-unit/main/spi/spi.h

#include <esp_err.h>

#define SPI_BUS SPI3_HOST
#define SPI_CLK_SPEED 8000000  // 8MHz

esp_err_t spi_init(uint8_t sclk_pin, uint8_t sout_pin, uint8_t sin_pin);
esp_err_t spi_send(uint8_t *data, int len);
