arcticlula/Netscore/software/v2.0 Prototype/side-unit/main/tasks.cpp

#include "tasks.h"

#include "button/button_actions.h"
#include "buzzer/buzzer.h"
#include "display/tlc5940/tlc5940.h"
#include "wifi/esp-now.h"

QueueHandle_t espnow_queue;
// QueueHandle_t button_action_queue;
QueueHandle_t melody_queue;
QueueHandle_t mirror_update_queue;

TaskHandle_t display_update_task_handle = NULL;
TaskHandle_t display_logic_task_handle = NULL;
TaskHandle_t espnow_task_handle = NULL;
TaskHandle_t button_task_handle = NULL;

void init_tasks(void) {
  espnow_queue = xQueueCreate(20, sizeof(esp_now_msg_t));
  // button_action_queue = xQueueCreate(15, sizeof(btn_action_t));
  //  adc_queue = xQueueCreate(10, sizeof(event_t));
  melody_queue = xQueueCreate(MELODY_QUEUE_LENGTH, sizeof(melody_note_t));
  mirror_update_queue = xQueueCreate(10, sizeof(mirror_state_t));

  xTaskCreate(display_update_task, "display_update_task", 4096, NULL, 4, &display_update_task_handle);
  xTaskCreate(display_logic_task, "display_logic_task", 4096, NULL, 3, &display_logic_task_handle);
  xTaskCreate(espnow_task, "espnow_task", 4096, NULL, 5, &espnow_task_handle);
  // xTaskCreate(button_task, "button_task", 4096, NULL, 4, &button_task_handle);

  // xTaskCreate(button_action_task, "button_action_task", 4096, NULL, 5, NULL);
  xTaskCreate(melody_task, "melody_task", 8192, NULL, 4, NULL);
  xTaskCreate(mirror_update_task, "mirror_upd_task", 4096, NULL, 5, NULL);
  // xTaskCreate(adc_task, "adc_task", 4096, NULL, 2, NULL);
}
