arcticlula/Netscore/software/web/web sim/src/display/display.cpp

#include "display.h"

#include "../definitions.h"
#include "../misc.h"
#include "../wifi/esp-now.h"
#include "display_init.h"
#include "tlc5940/tlc5940.h"

uint8_t menu_brightness = 50;

void show_display() {
  Tlc.clear();
  switch (window) {
    case BOOT_SCR:
      show_boot();
      break;
    case BOOT_2_SCR:
      show_boot_2();
      break;
    case BOOT_3_SCR:
      show_boot_3();
      break;
    case BOOT_4_SCR:
      show_boot_4();
      break;
    case SPORT_SCR:
      show_sport();
      break;
    case MENU_SCR:
      show_menu();
      break;
    case MENU_TRANSITION_SCR:
      show_menu_transition();
      break;
    case SET_MAX_SCORE_SCR:
      show_set_max_score();
      break;
    case SET_PADEL_GAME_TYPE_SCR:
      show_set_padel_game_type();
      break;
    case SET_PADEL_DEUCE_TYPE_SCR:
      show_set_deuce_type();
      break;
    case PLAY_SCR:
      show_play();
      break;
    case PLAY_HOME_WIN_SCR:
      show_play_result(HOME);
      break;
    case PLAY_AWAY_WIN_SCR:
      show_play_result(AWAY);
      break;
    case BRILHO_SCR:
      show_brightness();
      break;
    case BATT_SCR:
      show_battery();
      break;
    case BATT_DEVICE_SCR:
      show_device_battery();
      break;
    case OFF_SCR:
      show_off();
      break;
    case OFF_2_SCR:
      show_off_2();
      break;
  }
}

void show_boot() {
  show_fade_in(SIDE_BOTH, DIGIT_1, &df1);
  show_fade_in(SIDE_BOTH, DIGIT_2, &df2, init_boot_2_scr);
  show_fade_in(SIDE_BOTH, DIGIT_5, &df5);
  show_fade_in(SIDE_BOTH, DIGIT_6, &df6);
}

void show_boot_2() {
  show_wave(SIDE_BOTH, DIGIT_1, &dw1, init_boot_3_scr);
  show_wave(SIDE_BOTH, DIGIT_2, &dw2);
  show_wave(SIDE_BOTH, DIGIT_5, &dw5);
  show_wave(SIDE_BOTH, DIGIT_6, &dw6);
}

void show_boot_3() {
  show_wave(SIDE_BOTH, DIGIT_1, &dw1, init_boot_4_scr);
  show_wave(SIDE_BOTH, DIGIT_2, &dw2);
  show_wave(SIDE_BOTH, DIGIT_5, &dw5);
  show_wave(SIDE_BOTH, DIGIT_6, &dw6);
}

void show_boot_4() {
  show_fade_into(SIDE_BOTH, DIGIT_1, &dfi1, init_menu_scr);
  show_fade_into(SIDE_BOTH, DIGIT_2, &dfi2);
  show_fade_into(SIDE_BOTH, DIGIT_3, &dfi3);
  show_fade_into(SIDE_BOTH, DIGIT_4, &dfi4);
  show_fade_into(SIDE_BOTH, DIGIT_5, &dfi5);
  show_fade_into(SIDE_BOTH, DIGIT_6, &dfi6);
}

void show_sport() {
  switch (sport) {
    case SPORT_VOLLEY:
      show_text(SIDE_BOTH, V, O, L, E, I, BLANK, menu_brightness);
      break;
    case SPORT_PING_PONG:
      show_sport_ping_pong();
      break;
    case SPORT_PADEL:
      show_text(SIDE_BOTH, P, A, D, E, L, BLANK, menu_brightness);
      break;
  }
}

void show_sport_ping_pong() {
  static uint16_t cnt = 0;
  static uint8_t alt_letter = I;

  show_letter(SIDE_BOTH, DIGIT_1, P, menu_brightness);
  show_letter(SIDE_BOTH, DIGIT_2, alt_letter, menu_brightness);
  show_letter(SIDE_BOTH, DIGIT_5, N, menu_brightness);
  show_letter(SIDE_BOTH, DIGIT_6, G, menu_brightness);

  cnt++;
  if (cnt == 500) {
    alt_letter = alt_letter == I ? O : I;
    cnt = 0;
  }
}

void show_menu() { show_text(SIDE_BOTH, menu_options[menu], menu_brightness); }

void show_menu_transition() {
  show_fade_into(SIDE_BOTH, DIGIT_1, &dfi1);
  show_fade_into(SIDE_BOTH, DIGIT_2, &dfi2, init_menu_scr);
  show_fade_into(SIDE_BOTH, DIGIT_3, &dfi3);
  show_fade_into(SIDE_BOTH, DIGIT_4, &dfi4);
  show_fade_into(SIDE_BOTH, DIGIT_5, &dfi5);
  show_fade_into(SIDE_BOTH, DIGIT_6, &dfi6);
}

void show_set_max_score() {
  uint8_t digit_1 = max_score.min / 10;
  uint8_t digit_2 = max_score.min % 10;
  uint8_t digit_5 = max_score.max / 10;
  uint8_t digit_6 = max_score.max % 10;

  max_score.current == max_score.min ? show_wave(SIDE_BOTH, DIGIT_1, &dw1)
                                     : show_number(SIDE_BOTH, DIGIT_1, digit_1, 20);
  max_score.current == max_score.min ? show_wave(SIDE_BOTH, DIGIT_2, &dw2)
                                     : show_number(SIDE_BOTH, DIGIT_2, digit_2, 20);
  max_score.current == max_score.min ? show_zigzag(SIDE_BOTH, DIGIT_3, &dz1)
                                     : show_zigzag(SIDE_BOTH, DIGIT_4, &dz1);

  max_score.current == max_score.max ? show_wave(SIDE_BOTH, DIGIT_5, &dw1)
                                     : show_number(SIDE_BOTH, DIGIT_5, digit_5, 20);
  max_score.current == max_score.max ? show_wave(SIDE_BOTH, DIGIT_6, &dw2)
                                     : show_number(SIDE_BOTH, DIGIT_6, digit_6, 20);
}

volatile bool inf_patern_a = true;
volatile bool inf_patern_b = false;

void change_pattern_a() {
  inf_patern_a = false;
  inf_patern_b = true;
}

void change_pattern_b() {
  inf_patern_a = true;
  inf_patern_b = false;
}

void change_brightness_animated_index() {
  brightness_animated_index = brightness_animated_index + 1;
  if (brightness_animated_index == brightness_index * 2) brightness_animated_index = 0;
}

void show_set_padel_game_type() {
  uint8_t digit_1 = padel_game_type_option.first[0];
  uint8_t digit_2 = padel_game_type_option.first[1];
  uint8_t digit_5 = padel_game_type_option.last[0];
  uint8_t digit_6 = padel_game_type_option.last[1];

  if (padel_game_type_option.current == FIRST) {
    if (inf_patern_a) show_zigzag(SIDE_BOTH, DIGIT_1, &dz2, change_pattern_a);
    else
      show_letter(SIDE_BOTH, DIGIT_1, digit_1, 30);

    if (inf_patern_b) show_zigzag(SIDE_BOTH, DIGIT_2, &dz3, change_pattern_b);
    else
      show_letter(SIDE_BOTH, DIGIT_2, digit_2, 30);

    show_zigzag(SIDE_BOTH, DIGIT_3, &dz1);
  } else {
    show_letter(SIDE_BOTH, DIGIT_1, digit_1, 20);
    show_letter(SIDE_BOTH, DIGIT_2, digit_2, 20);
  }

  padel_game_type_option.current == LAST
      ? show_wave(SIDE_BOTH, DIGIT_5, &dw1)
      : show_letter(SIDE_BOTH, DIGIT_5, digit_5, 20);

  padel_game_type_option.current == LAST
      ? show_wave(SIDE_BOTH, DIGIT_6, &dw2)
      : show_letter(SIDE_BOTH, DIGIT_6, digit_6, 20);

  if (padel_game_type_option.current == LAST) {
    show_zigzag(SIDE_BOTH, DIGIT_4, &dz1);
  }
}

void show_set_deuce_type() {
  uint8_t digit_1 = padel_deuce_option.first[0];
  uint8_t digit_2 = padel_deuce_option.first[1];
  uint8_t digit_5 = padel_deuce_option.last[0];
  uint8_t digit_6 = padel_deuce_option.last[1];

  padel_deuce_option.current == FIRST ? show_wave(SIDE_BOTH, DIGIT_1, &dw1)
                                      : show_letter(SIDE_BOTH, DIGIT_1, digit_1, 20);
  padel_deuce_option.current == FIRST ? show_wave(SIDE_BOTH, DIGIT_2, &dw2)
                                      : show_letter(SIDE_BOTH, DIGIT_2, digit_2, 20);
  padel_deuce_option.current == FIRST ? show_zigzag(SIDE_BOTH, DIGIT_3, &dz1)
                                      : show_zigzag(SIDE_BOTH, DIGIT_4, &dz1);

  padel_deuce_option.current == LAST ? show_wave(SIDE_BOTH, DIGIT_5, &dw1)
                                     : show_letter(SIDE_BOTH, DIGIT_5, digit_5, 20);
  padel_deuce_option.current == LAST ? show_wave(SIDE_BOTH, DIGIT_6, &dw2)
                                     : show_letter(SIDE_BOTH, DIGIT_6, digit_6, 20);
}

void show_play() {
  sport == SPORT_PADEL ? show_play_padel() : show_play_default();
}

void show_play_default() {
  uint8_t current_max_score = max_score.current;  // Correct access
  bool home_set_point = score.home_points + 1 >= current_max_score &&
                        score.home_points - score.away_points >= 1;
  bool away_set_point = score.away_points + 1 >= current_max_score &&
                        score.away_points - score.home_points >= 1;
  uint8_t home_points_1 = score.home_points / 10;
  uint8_t home_points_2 = score.home_points % 10;
  uint8_t away_points_1 = score.away_points / 10;
  uint8_t away_points_2 = score.away_points % 10;

  show_number(SIDE_A, DIGIT_1, home_points_1, 50);
  show_number(SIDE_A, DIGIT_2, home_points_2, 50);
  show_number(SIDE_A, DIGIT_3, score.home_sets, 50);
  show_number(SIDE_A, DIGIT_4, score.away_sets, 50);
  show_number(SIDE_A, DIGIT_5, away_points_1, 50);
  show_number(SIDE_A, DIGIT_6, away_points_2, 50);

  // If next point is set point, show dot
  if (home_set_point) show_dot(SIDE_A, DIGIT_2, &dd1);
  if (away_set_point) show_dot(SIDE_A, DIGIT_6, &dd2);
}

void show_play_padel() {
  bool home_game_point, away_game_point, home_set_point, away_set_point;
  uint8_t home_points_1 = numbers[padel_score.home_points / 10];
  uint8_t home_points_2 = numbers[padel_score.home_points % 10];
  uint8_t away_points_1 = numbers[padel_score.away_points / 10];
  uint8_t away_points_2 = numbers[padel_score.away_points % 10];

  if (padel_score.tiebreak) {
    home_game_point = padel_score.home_points >= 6 && (padel_score.home_points - padel_score.away_points >= 1);
    away_game_point = padel_score.away_points >= 6 && (padel_score.away_points - padel_score.home_points >= 1);
    home_set_point = home_game_point;
    away_set_point = away_game_point;
  } else {
    if (golden_point) {
      home_game_point = padel_score.home_points == POINTS_40;
      away_game_point = padel_score.away_points == POINTS_40;
    } else {
      home_game_point = (padel_score.home_points == POINTS_40 && padel_score.away_points < POINTS_40) ||
                        padel_score.home_points == POINTS_ADV;
      away_game_point = (padel_score.away_points == POINTS_40 && padel_score.home_points < POINTS_40) ||
                        padel_score.away_points == POINTS_ADV;

      if (padel_score.home_points == POINTS_ADV) {
        home_points_1 = letters[A];
        home_points_2 = letters[D];
      } else if (padel_score.away_points == POINTS_ADV) {
        away_points_1 = letters[A];
        away_points_2 = letters[D];
      }
    }
    home_set_point = home_game_point && padel_score.home_games >= 5 && (padel_score.home_games - padel_score.away_games >= 1);
    away_set_point = away_game_point && padel_score.away_games >= 5 && (padel_score.away_games - padel_score.home_games >= 1);
  }

  show_character(SIDE_A, DIGIT_1, home_points_1, 50);
  show_character(SIDE_A, DIGIT_2, home_points_2, 50);
  show_number(SIDE_A, DIGIT_3, padel_score.home_games, 50);
  show_number(SIDE_A, DIGIT_4, padel_score.away_games, 50);
  show_character(SIDE_A, DIGIT_5, away_points_1, 50);
  show_character(SIDE_A, DIGIT_6, away_points_2, 50);

  // If next point is game point, show dot
  if (home_game_point) show_dot(SIDE_A, DIGIT_2, &dd1);
  if (away_game_point) show_dot(SIDE_A, DIGIT_6, &dd1);

  // If next point is set point, show dot
  if (home_set_point) show_dot(SIDE_A, DIGIT_3, &dd2);
  if (away_set_point) show_dot(SIDE_A, DIGIT_4, &dd2);
}

void show_play_result(uint8_t team) {
  sport == SPORT_PADEL ? show_play_result_padel(team) : show_play_result_default(team);
}

void show_play_result_default(uint8_t team) {
  uint8_t set_idx = score.home_sets + score.away_sets;
  if (set_idx > 0) set_idx--;  // Get the last played set

  uint8_t home_points_1 = score.set_points_home[set_idx] / 10;
  uint8_t home_points_2 = score.set_points_home[set_idx] % 10;
  uint8_t away_points_1 = score.set_points_away[set_idx] / 10;
  uint8_t away_points_2 = score.set_points_away[set_idx] % 10;

  set_number(&dw1.c, home_points_1);
  set_number(&dw2.c, home_points_2);
  set_number(&dw5.c, away_points_1);
  set_number(&dw6.c, away_points_2);

  if (team == HOME) {
    show_wave(SIDE_A, DIGIT_1, &dw1);
    show_wave(SIDE_A, DIGIT_2, &dw2);
    show_number(SIDE_A, DIGIT_5, away_points_1, 50);
    show_number(SIDE_A, DIGIT_6, away_points_2, 50);
  } else {
    show_number(SIDE_A, DIGIT_1, home_points_1, 50);
    show_number(SIDE_A, DIGIT_2, home_points_2, 50);
    show_wave(SIDE_A, DIGIT_5, &dw5);
    show_wave(SIDE_A, DIGIT_6, &dw6);
  }

  show_number(SIDE_A, DIGIT_3, score.home_sets, 50);
  show_number(SIDE_A, DIGIT_4, score.away_sets, 50);
}

void show_play_result_padel(uint8_t team) {
  uint8_t set_idx = padel_score.home_sets + padel_score.away_sets;
  if (set_idx > 0) set_idx--;  // Get the last played set

  uint8_t home_sets_1 = padel_score.home_sets / 10;
  uint8_t home_sets_2 = padel_score.home_sets % 10;
  uint8_t away_sets_1 = padel_score.away_sets / 10;
  uint8_t away_sets_2 = padel_score.away_sets % 10;

  uint8_t home_games = padel_score.set_games_home[set_idx];
  uint8_t away_games = padel_score.set_games_away[set_idx];

  set_number(&dw1.c, home_sets_1);
  set_number(&dw2.c, home_sets_2);
  set_number(&dw5.c, away_sets_1);
  set_number(&dw6.c, away_sets_2);

  if (team == HOME) {
    show_wave(SIDE_A, DIGIT_1, &dw1);
    show_wave(SIDE_A, DIGIT_2, &dw2);
    show_number(SIDE_A, DIGIT_5, away_sets_1, 50);
    show_number(SIDE_A, DIGIT_6, away_sets_2, 50);
  } else {
    show_number(SIDE_A, DIGIT_1, home_sets_1, 50);
    show_number(SIDE_A, DIGIT_2, home_sets_2, 50);
    show_wave(SIDE_A, DIGIT_5, &dw5);
    show_wave(SIDE_A, DIGIT_6, &dw6);
  }

  show_number(SIDE_A, DIGIT_3, home_games, 50);
  show_number(SIDE_A, DIGIT_4, away_games, 50);
}

void show_brightness() {
  uint8_t max_brightness_animated_index = brightness_index * 2 - 1;

  if (brightness_index == 0) {
    show_zigzag(SIDE_BOTH, DIGIT_1, &dz1, change_brightness_animated_index);
  } else if (brightness_index >= 1) {
    if (brightness_animated_index == 0) show_zigzag(SIDE_BOTH, DIGIT_1, &dz2, change_brightness_animated_index);
    else
      show_letter(SIDE_BOTH, DIGIT_1, O, 30);
  }

  if (brightness_index == 4) {
    if (brightness_animated_index == 4) show_zigzag(SIDE_BOTH, DIGIT_5, &dz3, change_brightness_animated_index);
    else
      show_letter(SIDE_BOTH, DIGIT_5, O, 30);
  } else if (brightness_index > 4) {
    if (brightness_animated_index == 4) show_zigzag(SIDE_BOTH, DIGIT_5, &dz4, change_brightness_animated_index);
    else if (brightness_animated_index == max_brightness_animated_index - 3)
      show_zigzag(SIDE_BOTH, DIGIT_5, &dz5, change_brightness_animated_index);
    else
      show_letter(SIDE_BOTH, DIGIT_5, O, 30);
  }

  if (brightness_index == 1) {
    if (brightness_animated_index == 1) show_zigzag(SIDE_BOTH, DIGIT_2, &dz3, change_brightness_animated_index);
    else
      show_letter(SIDE_BOTH, DIGIT_2, O, 30);
  } else if (brightness_index > 1) {
    if (brightness_animated_index == 1) show_zigzag(SIDE_BOTH, DIGIT_2, &dz4, change_brightness_animated_index);
    else if (brightness_animated_index == max_brightness_animated_index)
      show_zigzag(SIDE_BOTH, DIGIT_2, &dz5, change_brightness_animated_index);
    else
      show_letter(SIDE_BOTH, DIGIT_2, O, 30);
  }

  if (brightness_index == 5) {
    if (brightness_animated_index == 5) show_zigzag(SIDE_BOTH, DIGIT_6, &dz3, change_brightness_animated_index);
    else
      show_letter(SIDE_BOTH, DIGIT_6, O, 30);
  } else if (brightness_index > 5) {
    if (brightness_animated_index == 5) show_zigzag(SIDE_BOTH, DIGIT_6, &dz4, change_brightness_animated_index);
    else if (brightness_animated_index == max_brightness_animated_index - 4)
      show_zigzag(SIDE_BOTH, DIGIT_6, &dz5, change_brightness_animated_index);
    else
      show_letter(SIDE_BOTH, DIGIT_6, O, 30);
  }

  if (brightness_index == 2) {
    if (brightness_animated_index == 2) show_zigzag(SIDE_BOTH, DIGIT_3, &dz3, change_brightness_animated_index);
    else
      show_letter(SIDE_BOTH, DIGIT_3, O, 30);
  } else if (brightness_index > 2) {
    if (brightness_animated_index == 2) show_zigzag(SIDE_BOTH, DIGIT_3, &dz4, change_brightness_animated_index);
    else if (brightness_animated_index == max_brightness_animated_index - 1)
      show_zigzag(SIDE_BOTH, DIGIT_3, &dz5, change_brightness_animated_index);
    else
      show_letter(SIDE_BOTH, DIGIT_3, O, 30);
  }

  if (brightness_index == 3) {
    if (brightness_animated_index == 3) show_zigzag(SIDE_BOTH, DIGIT_4, &dz3, change_brightness_animated_index);
    else
      show_letter(SIDE_BOTH, DIGIT_4, O, 30);
  } else if (brightness_index > 3) {
    if (brightness_animated_index == 3) show_zigzag(SIDE_BOTH, DIGIT_4, &dz4, change_brightness_animated_index);
    else if (brightness_animated_index == max_brightness_animated_index - 2)
      show_zigzag(SIDE_BOTH, DIGIT_4, &dz5, change_brightness_animated_index);
    else
      show_letter(SIDE_BOTH, DIGIT_4, O, 30);
  }
}

void show_battery() {
  uint16_t bat_value = get_bat_value();
  uint8_t bat_perc = get_bat_percentage();
  uint8_t digit_1 = bat_value / 1000 % 10;
  uint8_t digit_2 = bat_value / 100 % 10;
  uint8_t digit_3 = bat_perc / 10 % 10;
  uint8_t digit_4 = bat_perc % 10;
  uint8_t digit_5 = bat_value / 10 % 10;
  uint8_t digit_6 = bat_value % 10;

  show_number(SIDE_BOTH, DIGIT_1, digit_1, 50);
  show_dot(SIDE_BOTH, DIGIT_1, 50);
  show_number(SIDE_BOTH, DIGIT_2, digit_2, 50);
  show_number(SIDE_BOTH, DIGIT_3, digit_3, 50);
  show_number(SIDE_BOTH, DIGIT_4, digit_4, 50);
  show_number(SIDE_BOTH, DIGIT_5, digit_5, 50);
  show_number(SIDE_BOTH, DIGIT_6, digit_6, 50);
}

void show_device_battery() {
  uint8_t bat_1 = get_device_battery(DEVICE_1);
  if (bat_1 > 99) bat_1 = 99;
  uint8_t bat_2 = get_device_battery(DEVICE_2);
  if (bat_2 > 99) bat_2 = 99;

  uint8_t d1_1 = bat_1 / 10;
  uint8_t d1_2 = bat_1 % 10;
  uint8_t d2_1 = bat_2 / 10;
  uint8_t d2_2 = bat_2 % 10;

  show_number(SIDE_A, DIGIT_1, d1_1, 50);
  show_number(SIDE_A, DIGIT_2, d1_2, 50);
  show_number(SIDE_A, DIGIT_5, d2_1, 50);
  show_number(SIDE_A, DIGIT_6, d2_2, 50);

  show_character(SIDE_BOTH, DIGIT_3, 0b01000000, 50);  // Dash
  show_character(SIDE_BOTH, DIGIT_4, 0b01000000, 50);  // Dash
}

void show_off() {
  show_wave(SIDE_BOTH, DIGIT_1, &dw1, init_off_2_scr);
  show_wave(SIDE_BOTH, DIGIT_5, &dw5);
  show_wave(SIDE_BOTH, DIGIT_2, &dw2);
  show_wave(SIDE_BOTH, DIGIT_6, &dw6);
}

void show_off_2() { show_text(SIDE_BOTH, B, Y, BLANK, BLANK, E, E, 1); }
