arcticlula/Netscore/software/web/web sim/src/display/display_init.cpp

#include "display_init.h"

#include "display.h"
#include "display_definitions.h"
#include "misc.h"
#include "wifi/esp-now.h"

void init_display() {
  init_boot_scr();
}

void init_boot_scr() {
  init_digit_fade(&df1, 50, 1, 400);
  init_digit_fade(&df2, 50, 1, 1000);
  init_digit_fade(&df5, 50, 1, 700);
  init_digit_fade(&df6, 50, 1, 800);

  set_letter(&df1.c, L);
  set_letter(&df2.c, U);
  set_letter(&df5.c, L);
  set_letter(&df6.c, A);
}

void init_boot_2_scr() {
  init_digit_wave(&dw1, 50, 50, 100, 0, 1, 500);
  init_digit_wave(&dw2, 50, 50, 100, 0, 1, 500);
  init_digit_wave(&dw5, 50, 50, 100, 0, 1, 500);
  init_digit_wave(&dw6, 50, 50, 100, 0, 1, 500);

  set_letter(&dw1.c, L);
  set_letter(&dw2.c, U);
  set_letter(&dw5.c, L);
  set_letter(&dw6.c, A);

  window = BOOT_2_SCR;
}

void init_boot_3_scr() {
  init_digit_wave(&dw1, 100, 50, 100, 0, -1, 500);
  init_digit_wave(&dw2, 100, 50, 100, 0, -1, 500);
  init_digit_wave(&dw5, 100, 50, 100, 0, -1, 500);
  init_digit_wave(&dw6, 100, 50, 100, 0, -1, 500);

  window = BOOT_3_SCR;
}

void init_boot_4_scr() {
  init_digit_fade_into(&dfi1, 50, 1000);
  init_digit_fade_into(&dfi2, 50, 1000);
  init_digit_fade_into(&dfi3, 50, 1000);
  init_digit_fade_into(&dfi4, 50, 1000);
  init_digit_fade_into(&dfi5, 50, 1000);
  init_digit_fade_into(&dfi6, 50, 1000);

  set_chars_fade_into(&dfi1, letters[L], letters[P]);
  set_chars_fade_into(&dfi2, letters[U], letters[L]);
  set_chars_fade_into(&dfi3, BLANK, BLANK);
  set_chars_fade_into(&dfi4, BLANK, BLANK);
  set_chars_fade_into(&dfi5, letters[L], letters[A]);
  set_chars_fade_into(&dfi6, letters[A], letters[Y]);

  window = BOOT_4_SCR;
  set_hold_time_ms(SMALL_HOLD_TIME_MS);
}

// void init_press_scr() {
//   init_digit_wave(&dw1, 50, 50, 80, 0, 1, 500);
//   init_digit_wave(&dw2, 50, 50, 80, 0, 1, 500);
//   init_digit_wave(&dw3, 50, 50, 80, 0, 1, 500);
//   init_digit_wave(&dw4, 50, 50, 80, 0, 1, 500);
//   init_digit_wave(&dw5, 50, 50, 80, 0, 1, 500);

//   init_digit_zigzag(&dz1, 0, 20, 80, 0, -1, 500);

//   set_letter(&dw1.c, P);
//   set_letter(&dw2.c, R);
//   set_letter(&dw3.c, E);
//   set_letter(&dw4.c, S);
//   set_letter(&dw5.c, S);

//   uint8_t positions[] = {0, 5, 4, 3};
//   set_positions(&dz1.c, positions, 4);

//   window = PRESS_SCR;
// }

void init_menu_scr() { window = MENU_SCR; }

void init_menu_transition_scr(uint8_t current_option, uint8_t next_option) {
  init_digit_fade_into(&dfi1, 50, 200);
  init_digit_fade_into(&dfi2, 50, 200);
  init_digit_fade_into(&dfi3, 50, 200);
  init_digit_fade_into(&dfi4, 50, 200);
  init_digit_fade_into(&dfi5, 50, 200);
  init_digit_fade_into(&dfi6, 50, 200);

  set_chars_fade_into(&dfi1, letters[menu_options[current_option][0]], letters[menu_options[next_option][0]]);
  set_chars_fade_into(&dfi2, letters[menu_options[current_option][1]], letters[menu_options[next_option][1]]);
  set_chars_fade_into(&dfi3, letters[menu_options[current_option][2]], letters[menu_options[next_option][2]]);
  set_chars_fade_into(&dfi4, letters[menu_options[current_option][3]], letters[menu_options[next_option][3]]);
  set_chars_fade_into(&dfi5, letters[menu_options[current_option][4]], letters[menu_options[next_option][4]]);
  set_chars_fade_into(&dfi6, letters[menu_options[current_option][5]], letters[menu_options[next_option][5]]);

  window = MENU_TRANSITION_SCR;
}

void init_sport_scr() { window = SPORT_SCR; }

void init_volley() {
  max_score.min = MIN_SCORE_VOLLEY;
  max_score.max = MAX_SCORE_VOLLEY;
  max_score.current = max_score.max;
  init_set_max_points_scr();
}

void init_ping_pong() {
  max_score.min = MIN_SCORE_PING_PONG;
  max_score.max = MAX_SCORE_PING_PONG;
  max_score.current = max_score.min;
  init_set_max_points_scr();
}

void init_padel() {
  padel_game_type_option.current = LAST;
  padel_deuce_option.current = LAST;
  init_set_padel_game_type_scr();
}

void init_set_max_points_scr() {
  init_digit_zigzag(&dz1, 0, 20, 80, 0, -1, 500);

  init_digit_wave(&dw1, 100, 50, 100, 0, -1, 500);
  init_digit_wave(&dw2, 100, 50, 100, 0, -1, 500);

  set_number(&dw1.c, max_score.current / 10);
  set_number(&dw2.c, max_score.current % 10);

  if (max_score.current == max_score.max) {
    uint8_t positions[] = {0, 5, 4, 3};
    set_positions(&dz1.c, positions, 4);
  } else {
    uint8_t positions[] = {0, 1, 2, 3};
    set_positions(&dz1.c, positions, 4);
  }

  window = SET_MAX_SCORE_SCR;
}

void init_set_padel_game_type_scr() {
  init_digit_wave(&dw1, 100, 50, 100, 0, -1, 500);
  init_digit_wave(&dw2, 100, 50, 100, 0, -1, 500);

  if (padel_game_type_option.current == FIRST) {
    uint8_t positions[] = {0, 5, 4, 3};
    uint8_t a[] = {2, 3, 4, 5, 0, 1};
    uint8_t b[] = {4, 3, 2, 1, 0, 5};
    set_positions(&dz1.c, positions, 4);
    set_positions(&dz2.c, a, 6);
    set_positions(&dz3.c, b, 6);
  } else if (padel_game_type_option.current == LAST) {
    uint8_t positions[] = {0, 1, 2, 3};
    set_letter(&dw1.c, padel_game_type_option.last[0]);
    set_letter(&dw2.c, padel_game_type_option.last[1]);
    set_positions(&dz1.c, positions, 4);
  }

  init_digit_zigzag(&dz1, 0, 20, 80, 0, -1, 500);
  init_digit_zigzag(&dz2, 0, 60, 80, 30, 1, 500);
  init_digit_zigzag(&dz3, 0, 60, 80, 30, 1, 500);
  window = SET_PADEL_GAME_TYPE_SCR;
}

void init_set_padel_deuce_type_scr() {
  if (padel_deuce_option.current == FIRST) {
    uint8_t positions[] = {0, 5, 4, 3};
    set_letter(&dw1.c, padel_deuce_option.first[0]);
    set_letter(&dw2.c, padel_deuce_option.first[1]);
    set_positions(&dz1.c, positions, 4);
  } else if (padel_deuce_option.current == LAST) {
    uint8_t positions[] = {0, 1, 2, 3};
    set_letter(&dw1.c, padel_deuce_option.last[0]);
    set_letter(&dw2.c, padel_deuce_option.last[1]);
    set_positions(&dz1.c, positions, 4);
  }

  init_digit_zigzag(&dz1, 0, 20, 80, 0, -1, 500);
  window = SET_PADEL_DEUCE_TYPE_SCR;
}

void init_play_scr() {
  init_digit_dot(&dd1, 50, 0, 50, -1, 1000);
  init_digit_dot(&dd2, 50, 0, 50, -1, 1000);

  window = PLAY_SCR;
  set_hold_time_ms(BIG_HOLD_TIME_MS);
}

void init_play_result_scr(uint8_t team) {
  init_digit_wave(&dw1, 50, 50, 100, 0, 1, 1000);
  init_digit_wave(&dw2, 50, 50, 100, 0, 1, 1000);
  init_digit_wave(&dw5, 50, 50, 100, 0, 1, 1000);
  init_digit_wave(&dw6, 50, 50, 100, 0, 1, 1000);
  window = team == HOME ? PLAY_HOME_WIN_SCR : PLAY_AWAY_WIN_SCR;
}

void advance_after_set() {
  if (sport == SPORT_PADEL) {
    init_play_scr();
  } else {
    init_set_max_points_scr();
  }
}

void init_brightness_scr() {
  brightness_animated_index = 0;

  uint8_t a[] = {3, 4, 5, 0, 1, 2};
  uint8_t b1[] = {3, 4, 5, 0};
  uint8_t b2[] = {0, 1, 2, 3};
  uint8_t c1[] = {0};
  uint8_t c2[] = {3};

  set_positions(&dz1.c, a, 6);

  set_positions(&dz2.c, b1, 4, a, 6);
  set_positions(&dz3.c, b2, 4, a, 6);

  set_positions(&dz4.c, c1, 1, a, 6);
  set_positions(&dz5.c, c2, 1, a, 6);

  init_digit_zigzag(&dz1, 0, 60, 80, 30, 1, 600);
  init_digit_zigzag(&dz2, 0, 60, 80, 30, 1, 400);
  init_digit_zigzag(&dz3, 0, 60, 80, 30, 1, 400);
  init_digit_zigzag(&dz4, 0, 60, 80, 30, 1, 100);
  init_digit_zigzag(&dz5, 0, 60, 80, 30, 1, 100);
  window = BRILHO_SCR;
}

void init_bat_scr() {
  // init_digit_dot(&dd1, 50, 0, 50, -1, 1000);

  reset_adc();
  window = BATT_SCR;
}

void init_device_bat_scr() {
  esp_now_device_battery(DEVICE_1);
  esp_now_device_battery(DEVICE_2);
  window = BATT_DEVICE_SCR;
}

void init_off_scr() {
  init_digit_wave(&dw1, 50, 1, 50, 0, -1, 2000);
  init_digit_wave(&dw2, 50, 1, 50, 0, -1, 2000);
  init_digit_wave(&dw5, 50, 1, 50, 0, -1, 2000);
  init_digit_wave(&dw6, 50, 1, 50, 0, -1, 2000);

  set_letter(&dw1.c, B);
  set_letter(&dw2.c, Y);
  set_letter(&dw5.c, E);
  set_letter(&dw6.c, E);
  window = OFF_SCR;
}

void init_off_2_scr() {
  window = OFF_2_SCR;
}
