arcticlula/Netscore/software/web/web sim/src/display/display_definitions.cpp

#include "display_definitions.h"

// Digits
digit_wave_t dw1, dw2, dw3, dw4, dw5, dw6;
digit_zigzag_t dz1, dz2, dz3, dz4, dz5, dz6;
digit_loop_t dl1;
digit_fade_t df1, df2, df3, df4, df5, df6;
digit_fade_into_t dfi1, dfi2, dfi3, dfi4, dfi5, dfi6;
digit_dot_t dd1, dd2;
