arcticlula/Netscore/software/web/web sim/src/display/display_init.h

#pragma once
#include "display_api.h"
#include "display_definitions.h"

void init_display();
void init_boot_scr();
void init_boot_2_scr();
void init_boot_3_scr();
void init_boot_4_scr();
void init_press_scr();
void init_menu_scr();
void init_menu_transition_scr(uint8_t current_option, uint8_t next_option);
void init_sport_scr();
void init_volley();
void init_ping_pong();
void init_padel();
void init_set_max_points_scr();
void init_set_padel_game_type_scr();
void init_set_padel_deuce_type_scr();
void init_play_scr();
void init_play_result_scr(uint8_t team);
void advance_after_set();
void init_brightness_scr();
void init_bat_scr();
void init_device_bat_scr();
void init_test_scr();
void init_off_scr();
void init_off_2_scr();
