arcticlula/Netscore/(commit log)

2024-11-04 Added display board pcb
    [display-board.kicad_pcb, display-board.kicad_sch]
2025-01-12 Added main board to the hw folder, some 3d models for the inner structure and the code itself
    [BOM-display-board.csv, BOM-main-board.csv, Regulators.kicad_sch, battery_management.kicad_sch, board-union-v1.stl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]
2025-03-03 Added project basis, software, hardware and 3d models
    [.uncrustify.cfg, cmn_crt_authorities.csv, esp_efuse_table.csv, esp_efuse_table_v0.0_v1.1.csv, esp_efuse_test_table.csv, inner-board-side-a-v1.stl, inner-board-side-a-v2.stl, inner-board-side-a-v3.stl]
2025-03-11 renamed some funcs/vars from camelCase to snake_case, added padel, moved initTasks to the end
    [btn.stl, main-board.kicad_sch, outer-handle-v2.stl]
2025-03-11 improved system (tasks) stability, completed padel mode with new set_win and set_score screens
    [button_actions.cpp, definitions.cpp, definitions.h, display.cpp, display.h, display_init.cpp, display_init.h, main.cpp]
2025-03-12 added menu_transition, fixed off screen
    [button_actions.cpp, definitions.cpp, definitions.h, display.cpp, display.h, display_api.cpp, display_api.h, display_init.cpp]
2025-11-27 button logic is done now in the hub to reduce latency between click and release, restructured folders
    [.uncrustify.cfg, BOM-display-board.csv, BOM-main-board.csv, Regulators.kicad_sch, battery_management.kicad_sch, btn-v1.0.stl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]
2025-11-27 more than one button can be paired and connection status
2025-12-17 Changed stack to use ble instead (hid over gatt), added new type of button (ITAG) and support for different Ab Shutter models (1 and 2 buttons))
2025-12-18 redid the button logic so the main focus is each different screen, and then the different button presses; undo point reverts for each team instead of previous, reworked the flow
    [button_actions.cpp, button_actions.h, button_actions_helper.cpp, button_actions_helper.h, buzzer.cpp, buzzer.h, definitions.h, display.cpp]
2026-03-03 added improved versions for the struct
    bottom has now the ability to attach suction cups (padel glass)
    inner struct has been simplified to be printable in one go
    [inner-struct-v2.0.stl, inner-struct-v2.1.stl, outer-bottom-v1.99.stl, outer-bottom-v2.0.stl]
2026-03-03 improved bl connection logic, refractored led value weight and its now being applied to the correct digits
    added nvs storage also
    [buzzer.cpp, definitions.h, storage.cpp, storage.h]
2026-03-03 created a version of the original esp32/esp32s2 code to run on an esp32s3
2026-03-03 Created new version where it is all centralized in the esp32s3
    also created side unit, can act as a receiver for the main unit and mirror its content
    [partitions.csv]
2026-03-04 Fixed ble and wifi transmission issues
    in part because of a hardware antenna replacement
    [ble.c, definitions.h]
2026-03-09 updated v2 main board
    removed redundant parts (light sensor that was never used and many jumpers)
    added an analog switch to detect and route mosi signal to display board
    fixed batt circuit
    replaced single row connectors by one double each side (mirrored)
    [main-board.kicad_sch]
2026-03-11 updated main board schematic
    [main-board.kicad_sch]
2026-03-16 added docs and v2 of the main pcb is about done
    [main-board.kicad_pcb, main-board.kicad_sch]
2026-03-19 v2.0 of the main and display board is ready and in production
    [BOM-display-board.csv, bom.csv, designators.csv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]
2026-04-15 detected wrong connections in the rtc module
    [main-board.kicad_sch]
2026-04-30 new version in the works, time is not yet functional but the new board is very much working
    ds3231 vbat is switched with the vcc - fixed
    have to fix capacitor resonance since it is really annoying
    [addonv1.0.stl, bom.csv, bottom-v1.0.stl, btn-v1.0.stl, designators.csv, display-board.kicad_pcb, display-board.kicad_sch, inner-struct-union-v1.0.stl]
2026-05-18 refined screens in v2.0, usb detection and sleep modes, some tweaks in the spi transmission solves brightness switching, esp now disabled for now since the peak currents sometimes reset the led driver
    also matched the netscore online demo's logic to the currently being used on the devices, developed new 3d models for the new boards
    [bom.csv, designators.csv, display-board.kicad_pcb, display-board.kicad_sch, inner-body-big-v1.0.stl, inner-body-v1.0.stl, inner-body-v1.1.stl, inner-body-v1.5.stl]
2026-05-19 testing big board
2026-06-29 Added new web simulator for new board revision with time digits, added web app to control settings and retrieve match data, regarding the unit see description
    added more sports
    added mirror mode (in progress still)
    added config menu to play screen
    serve select mode
    some test modes (all is good to check if everything lights up)
    added boot to match shortcuts
    fixed buzzer driving even though it is too loud right now and still lights up drv8833 fault led
    delayed esp now to average out peak energy (ble btn pressed, esp now sent, led bars max brightness, buzzer beeping at the same time)
    previous also related to longstanding bug of the tcl5951 getting brownouted
    split nvs writes into chuncks also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
    [gg.stl, outer-bottom-big-v1.0.stl, outer-top-big-v1.0.stl, partitions.csv, top big.3mf]
2026-08-19 Add dual-target main-unit firmware with v2.0/v3.0 board HAL
    Brings the previously untracked software/main-unit project under version
    control. This is the unified firmware that targets both main board
    revisions from one source tree, selected at build time via
    CONFIG_NETSCORE_BOARD_V20 / _V30.
    Board-specific code is isolated behind main/boards/board.h:
    - v3.0: DRV8662 piezo driver (sigma-delta sine synthesis + EN
    sequencing) and a PCNT rotary encoder replacing the three nav
    buttons; netlist-verified v3.0 pin map, with RTC_INT moved to
    GPIO10 so it can serve as an EXT0/EXT1 deep-sleep wake source.
    - v2.0: DRV8833 H-bridge buzzer and the original three-button nav.
    Also ignore t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
    [partitions.csv]
2026-08-20 Split v3.0 firmware into its own project, drop the shared board HAL
    v2.0 hardware is frozen, so the dual-target tree was a constraint with no
    remaining benefit: v3.0 needs to diverge freely for sleep modes and power
    management, and keeping v2.0 buildable from the same sources only taxes
    that work.
    software/main-unit now becomes software/v3.0/main-unit, targeting v3.0
    only. The board HAL is gone -- no boards/, no Kconfig board choice, no
    per-revision sdkconfig, one build directory:
    - boards/v30/pins.h is inlined into definitions.h
    - the DRV8662 driver (SDM sine synthesis + EN sequencing) is inlined
    into buzzer/buzzer.cpp as static drv8662_* functions
    - the PCNT rotary encoder is i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
    [partitions.csv]
2026-09-16 Sync the web app lockfile so npm ci works in CI
    The committed lock predated the current @emnapi transitive deps, so
    `npm ci` refused to install and the first Pages run failed at that step.
    Regenerated with npm install; verified npm ci + vite build from a clean
    copy of the tree.
2026-09-16 Pin CI to node 24.12.0 and npm 11.6.2
    node-version '24' floats to 24.20.0, which ships npm 12; npm 12 rejects
    our lock over the same optional @emnapi peer deps npm 10 does. npm 11
    omits them by design, so CI has to run the npm that writes the lock.
    Pin both and print the version so a future drift is visible in the log.
