arcticlula/Netscore/(notices)

Notices in the files:
software/v2.0 Prototype/side-unit/main/display/tlc5940/tlc_config.h:
and/or modify it under the terms of the GNU General Public License as
published by the Free Software Foundation, either version 3 of the
License, or (at your option) any later version.
